BrotherLaur/ApocalypseController/Documentation/CONTROL_Block.png

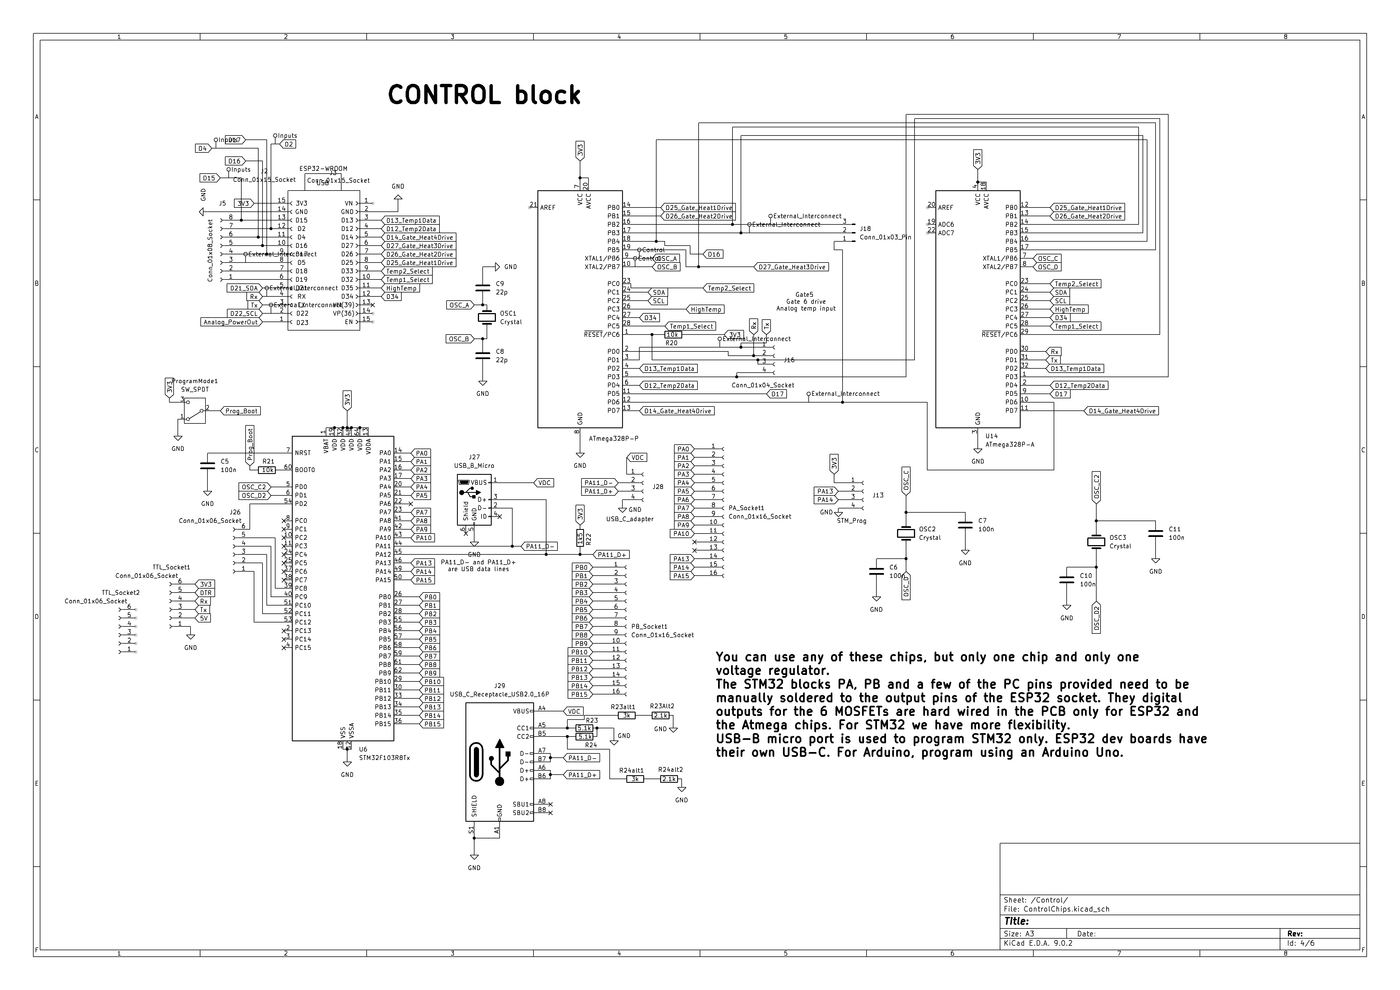
Documentation/CONTROL_Block.png
