BrotherLaur/ApocalypseController/Documentation/GATE_DRIVERS_Block.png

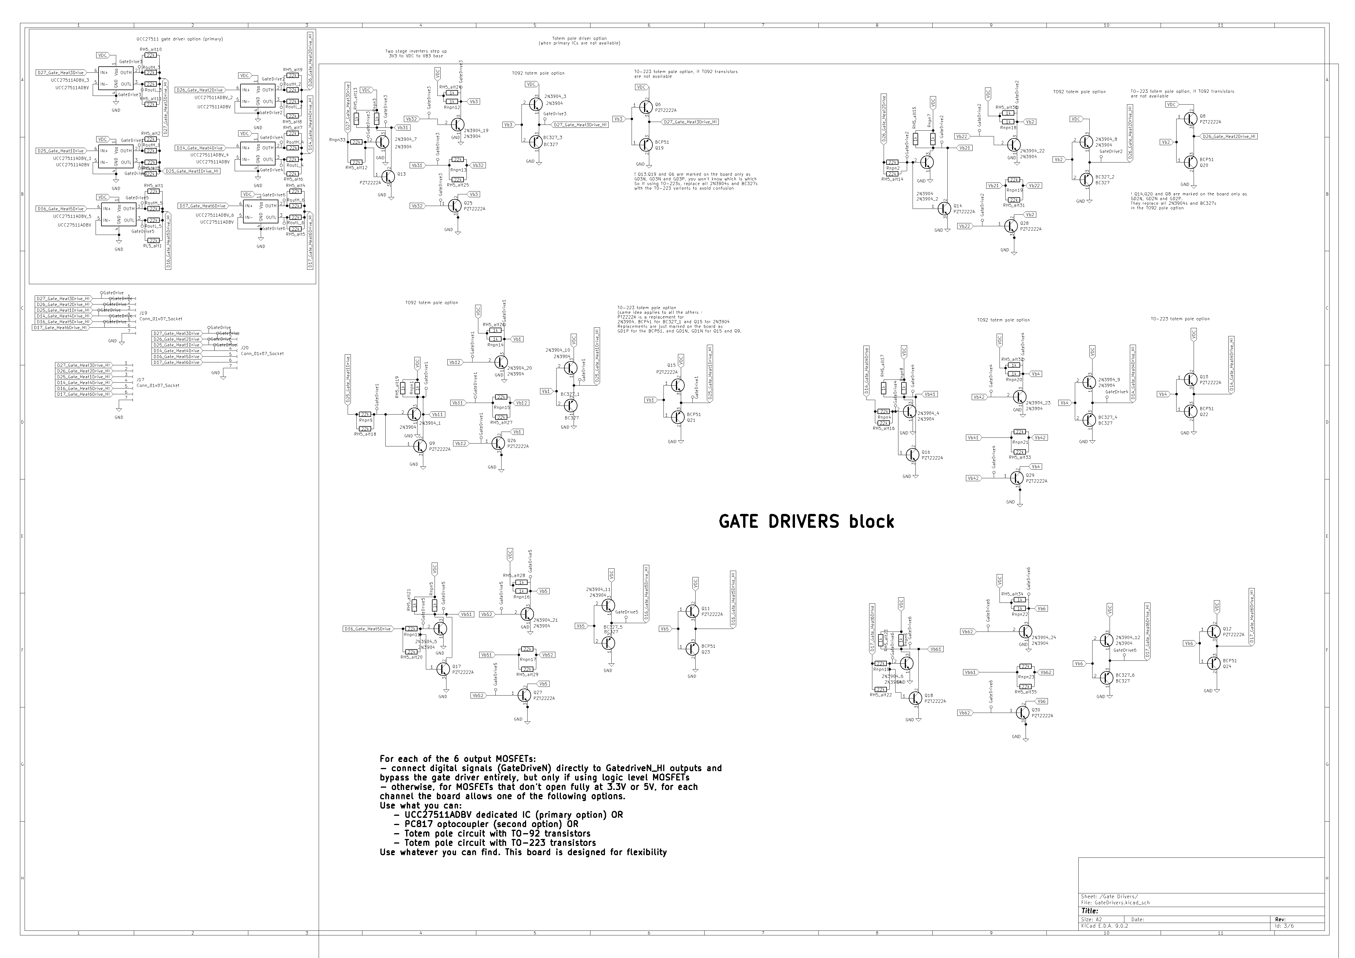
Documentation/GATE_DRIVERS_Block.png
