BrotherLaur/ApocalypseController/Documentation/INPUTS_Block.png

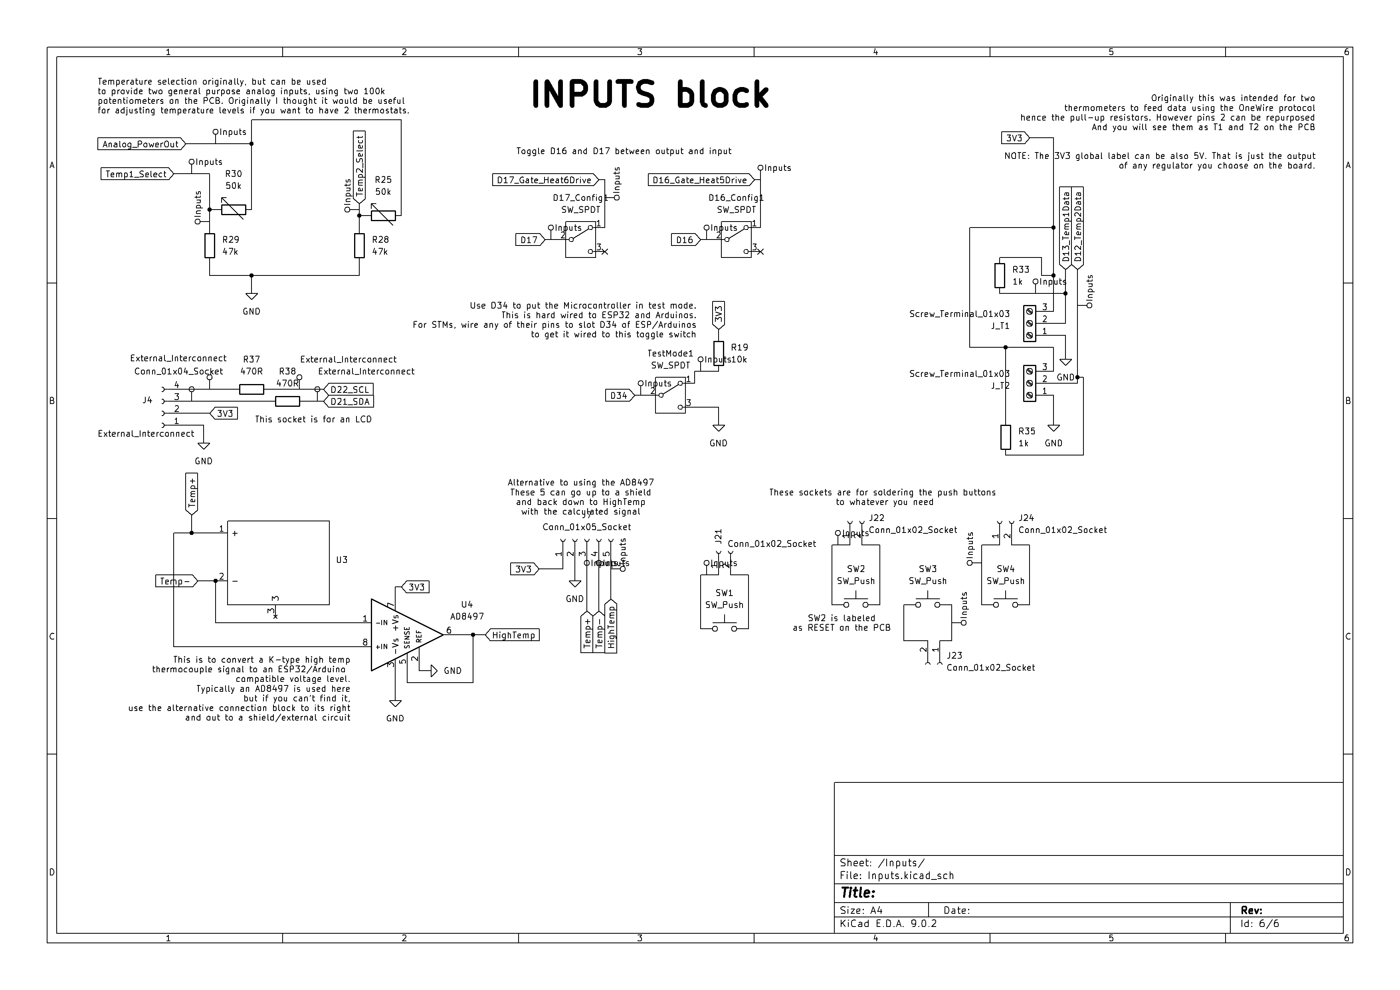
Documentation/INPUTS_Block.png
