BrotherLaur/ApocalypseController/Documentation/OUTPUT_Block.png

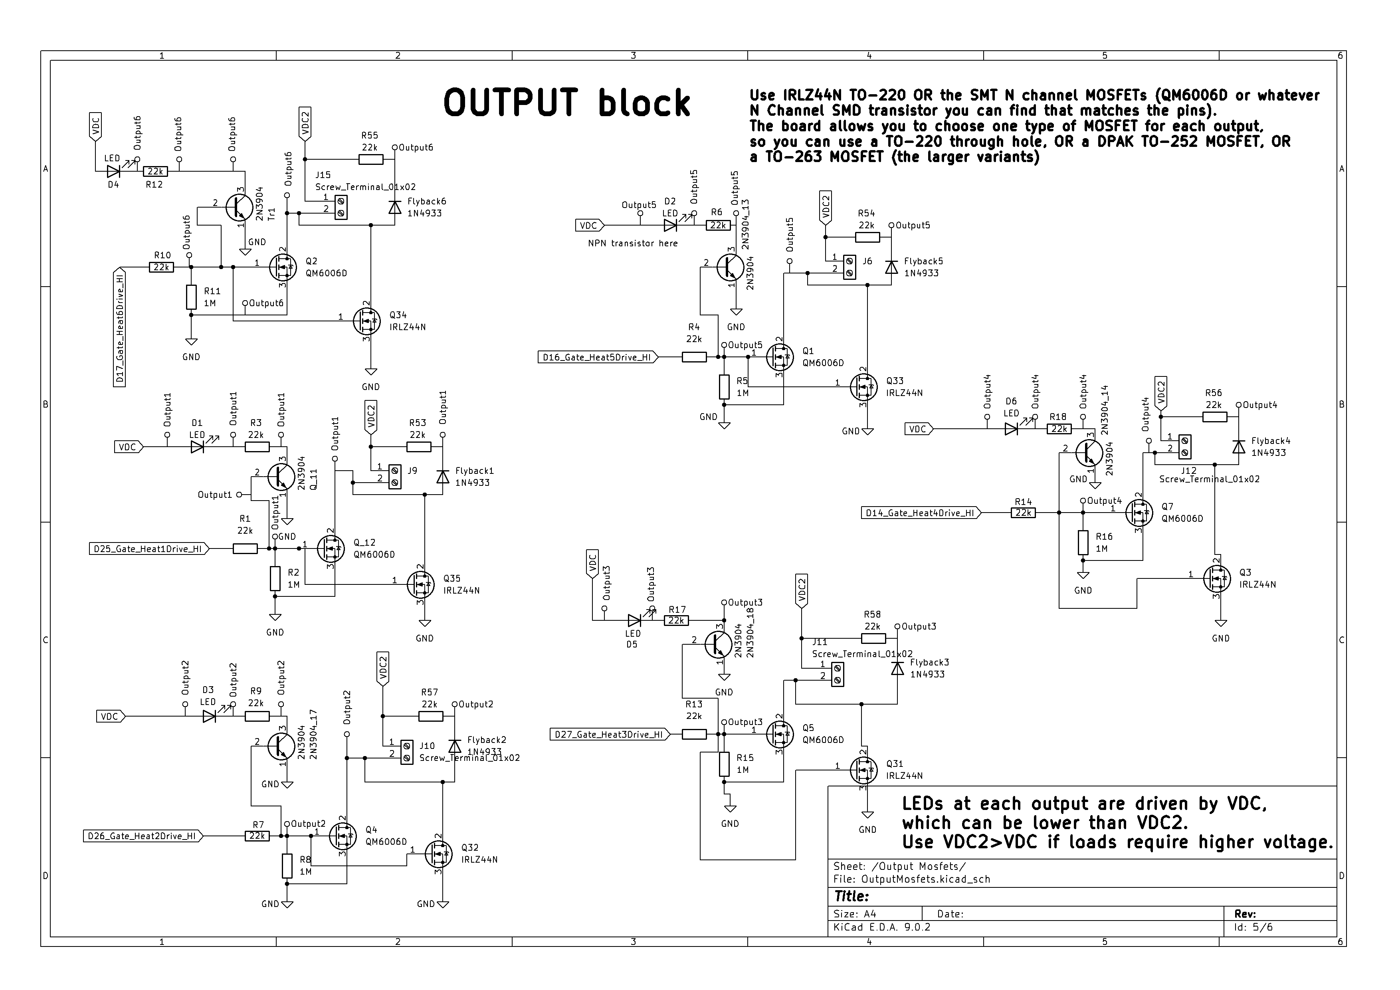
Documentation/OUTPUT_Block.png
