BrotherLaur/ApocalypseController/Documentation/Overview.png

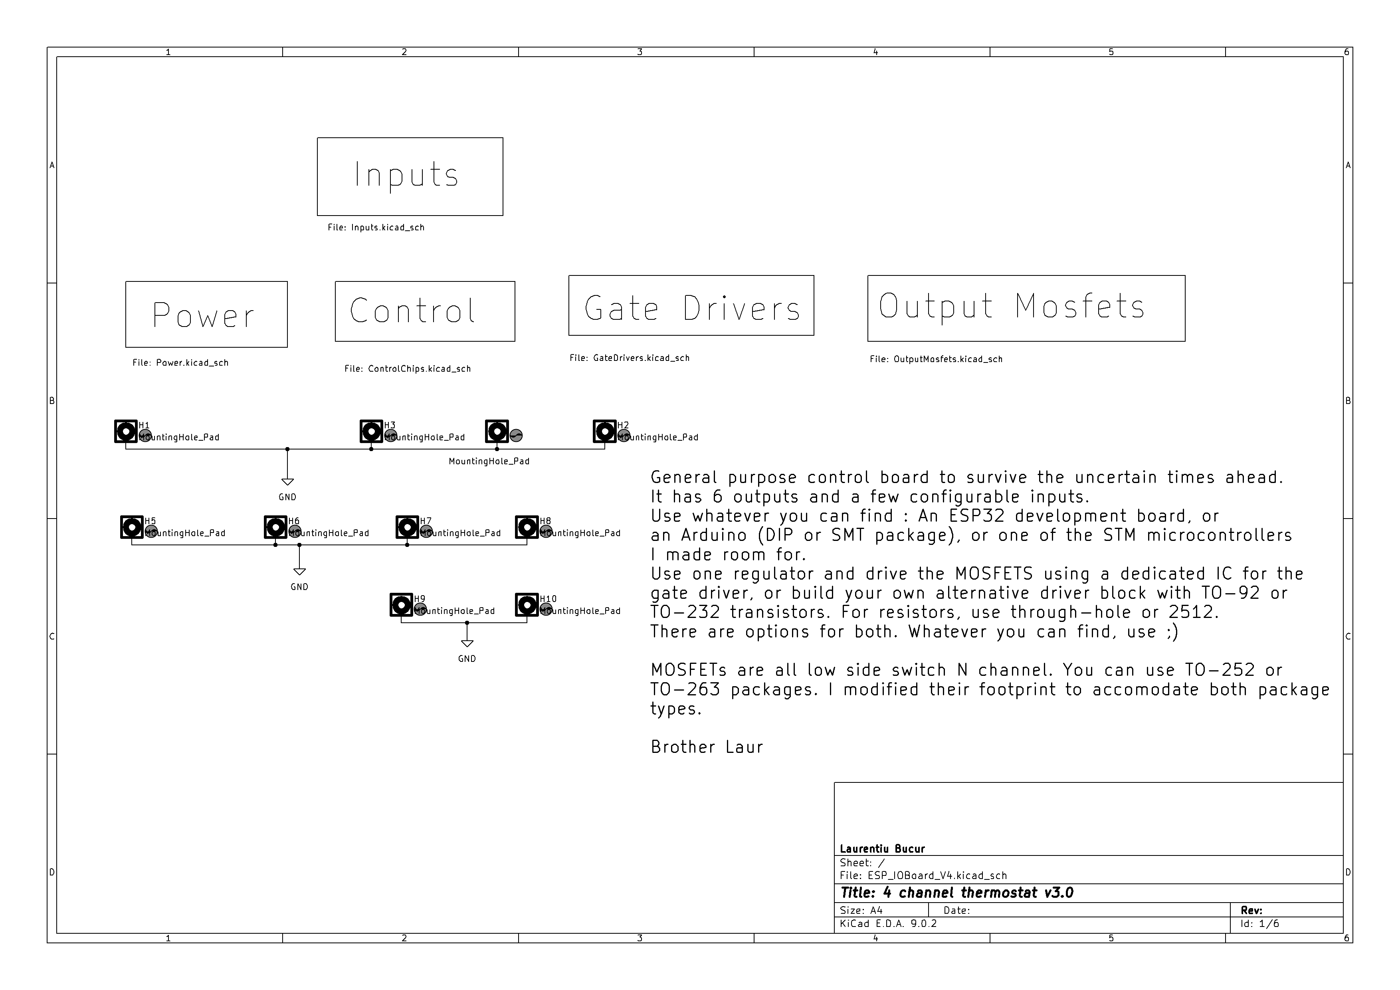
Documentation/Overview.png
