BrotherLaur/ApocalypseController/Documentation/POWER_Block.png

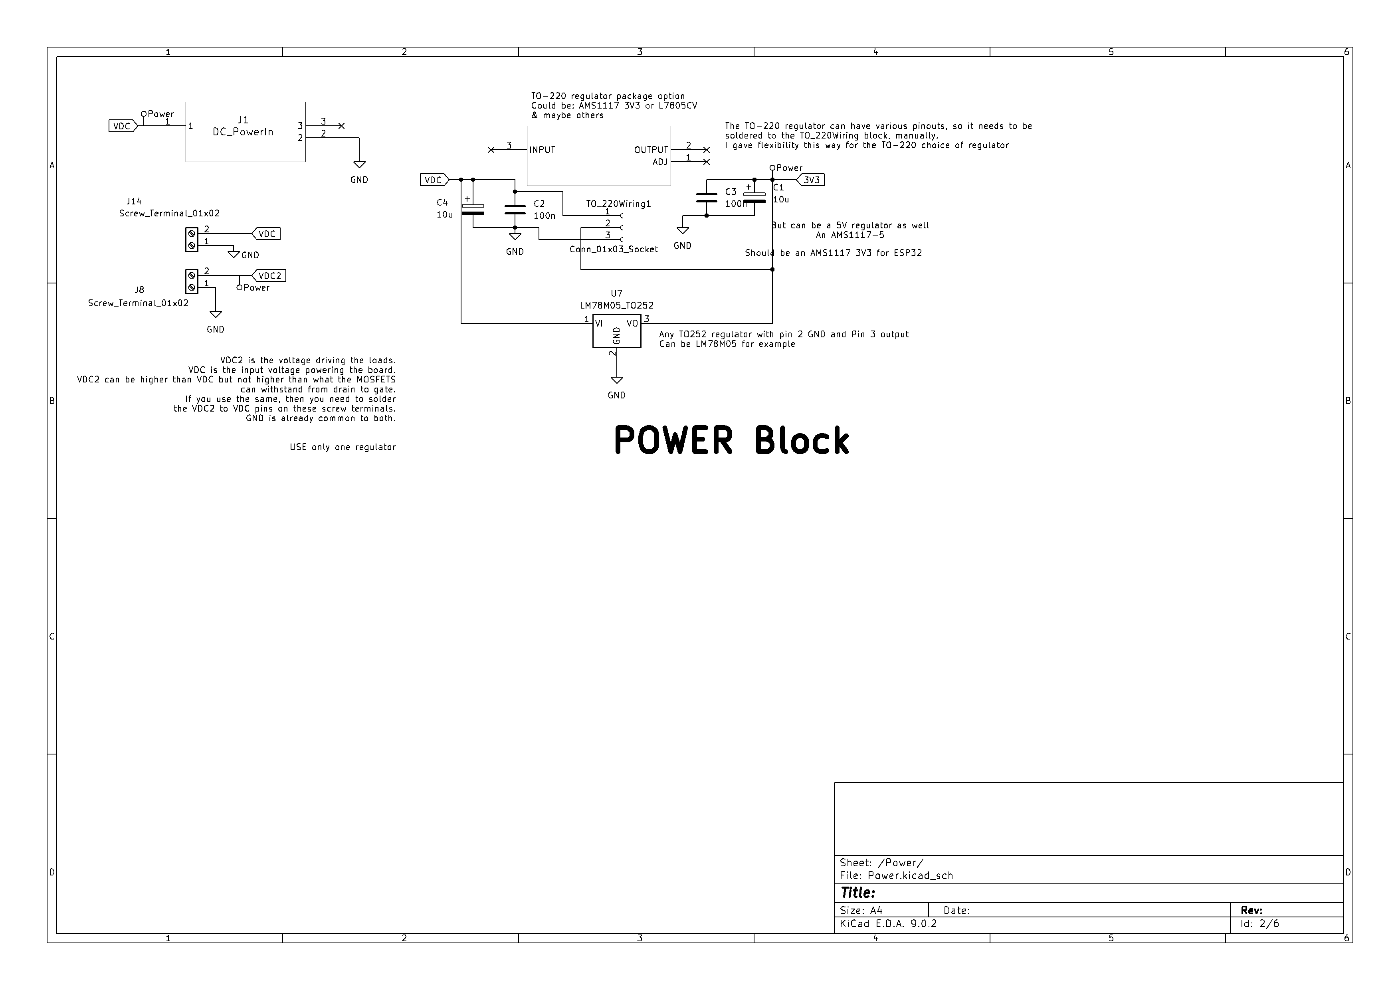
Documentation/POWER_Block.png
