BrotherLaur/ApocalypseController/ControlChips.kicad_sch

## KiCad design ControlChips.kicad_sch (2025-10-03)

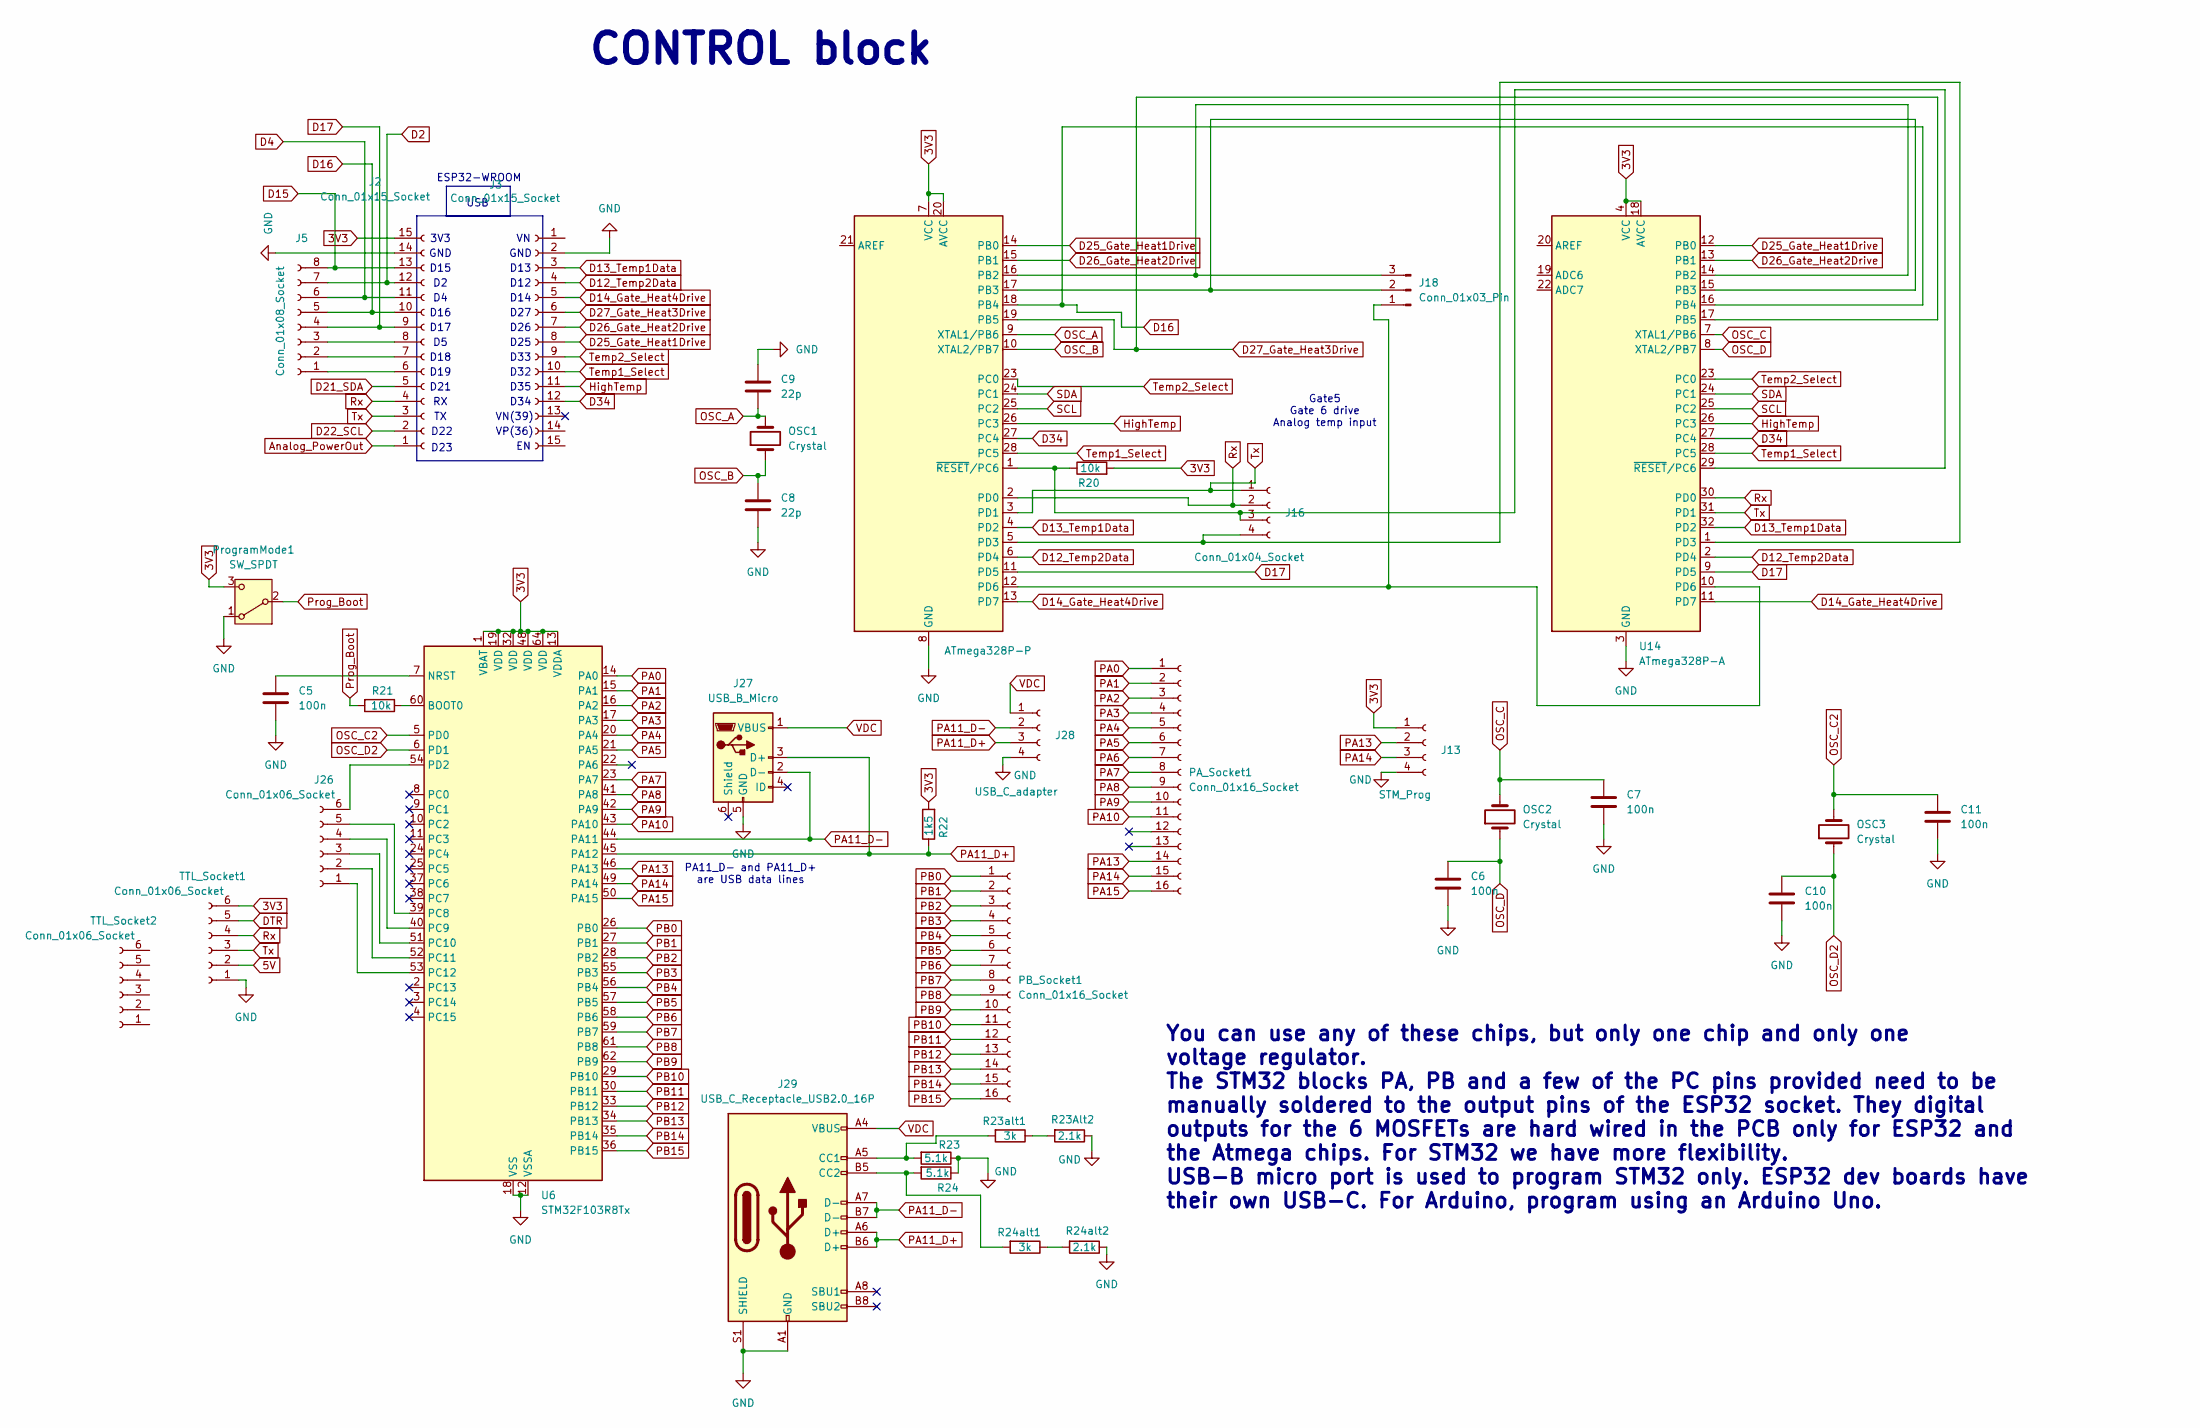
[picture p7: schematic ControlChips.kicad_sch]

Parts:
C5, C6, C7, C10, C11: 100n; C_Rect_L7.0mm_W3.5mm_P5.00mm
C8, C9: 22p; C_Rect_L7.0mm_W3.5mm_P5.00mm
J2, J3: Conn_01x15_Socket; PinSocket_1x15_P2.54mm_Vertical
J5: Conn_01x08_Socket; PinSocket_1x08_P2.54mm_Vertical
J13: STM_Prog; PinSocket_1x04_P2.54mm_Vertical
J16: Conn_01x04_Socket; PinSocket_1x04_P2.54mm_Vertical
J18: Conn_01x03_Pin; PinHeader_1x03_P2.54mm_Vertical
J26: Conn_01x06_Socket; PinSocket_1x06_P2.54mm_Vertical
J27: USB_B_Micro; USB_Micro-B_Wuerth_629105150521
J28: USB_C_adapter; PinSocket_1x04_P2.54mm_Vertical
J29: USB_C_Receptacle_USB2.0_16P; USB_C_Receptacle_GCT_USB4085
OSC1, OSC2, OSC3: Crystal; Crystal_HC49-U_Vertical
PA_Socket1: Conn_01x16_Socket; PinSocket_1x16_P2.54mm_Vertical
PB_Socket1: Conn_01x16_Socket; PinSocket_1x16_P2.54mm_Vertical
ProgramMode1: SW_SPDT; PinHeader_1x03_P2.54mm_Vertical
R20, R21: 10k; R_Axial_Clean
R22: 1k5; R_Axial_Clean
R23, R24: 5.1k; D_2512_6332Metric
R23Alt2, R24alt2: 2.1k; R_Axial_Clean
R23alt1, R24alt1: 3k; R_Axial_Clean
TTL_Socket1, TTL_Socket2: Conn_01x06_Socket; PinSocket_1x06_P2.54mm_Vertical
U5: ATmega328P-P; DIP-28_W7.62mm_Socket
U6: STM32F103R8Tx; LQFP-64_10x10mm_P0.5mm
U14: ATmega328P-A; TQFP-32_SLIM

Connections:
3V3: J2.15, J13.1, ProgramMode1.3 (C), R20.2, R22.2, TTL_Socket1.6, U5.7 (VCC), U5.20 (AVCC), U6.1 (VBAT), U6.13 (VDDA), U6.19 (VDD), U6.32 (VDD), U6.48 (VDD), U6.64 (VDD), U14.4 (VCC), U14.6 (VCC), U14.18 (AVCC)
5V: TTL_Socket1.2
Analog_PowerOut: J2.1
D2: J2.12, J5.7
D4: J2.11, J5.6
D12_Temp2Data: J3.4, U5.6 (PD4), U14.2 (PD4)
D13_Temp1Data: J3.3, U5.4 (PD2), U14.32 (PD2)
D14_Gate_Heat4Drive: J3.5, U5.13 (PD7), U14.11 (PD7)
D15: J2.13, J5.8
D16: J2.10, J5.5, U5.18 (PB4), U14.16 (PB4)
D17: J2.9, J5.4, U5.11 (PD5), U14.9 (PD5)
D21_SDA: J2.5
D22_SCL: J2.2
D25_Gate_Heat1Drive: J3.8, U5.14 (PB0), U14.12 (PB0)
D26_Gate_Heat2Drive: J3.7, U5.15 (PB1), U14.13 (PB1)
D27_Gate_Heat3Drive: J3.6, U5.19 (PB5), U14.17 (PB5)
D34: J3.12, U5.27 (PC4), U14.27 (PC4)
DTR: TTL_Socket1.5
GND: C5.2, C6.2, C7.2, C8.2, C9.1, C10.2, C11.2, J2.14, J3.2, J13.4, J27.5 (GND), J28.4, J29.A1 (GND), J29.A12 (GND), J29.B1 (GND), J29.B12 (GND), J29.S1 (SHIELD), ProgramMode1.1 (A), R23.1, R23Alt2.1, R24.1, R24alt2.1, TTL_Socket1.1, U5.8 (GND), U5.22 (GND), U6.12 (VSSA), U6.18 (VSS), U6.31 (VSS), U6.47 (VSS), U6.63 (VSS), U14.3 (GND), U14.5 (GND), U14.21 (GND)
HighTemp: J3.11, U5.26 (PC3), U14.26 (PC3)
unnamed: C5.1, U6.7 (NRST)
unnamed: J2.6, J5.1
unnamed: J2.7, J5.2
unnamed: J2.8, J5.3
unnamed: J16.3, R20.1, U5.1 (~RESET/PC6), U14.29 (~RESET/PC6)
unnamed: J16.4, U5.5 (PD3), U14.1 (PD3)
unnamed: J18.1, U5.12 (PD6), U14.10 (PD6)
unnamed: J18.2, U5.17 (PB3), U14.15 (PB3)
unnamed: J18.3, U5.16 (PB2), U14.14 (PB2)
unnamed: J26.1, U6.53 (PC12)
unnamed: J26.2, U6.52 (PC11)
unnamed: J26.3, U6.51 (PC10)
unnamed: J26.4, U6.40 (PC9)
unnamed: J26.5, U6.39 (PC8)
unnamed: J26.6, U6.54 (PD2)
unnamed: J29.A5 (CC1), R23.2, R23alt1.2
unnamed: J29.B5 (CC2), R24.2, R24alt1.2
unnamed: R21.1, U6.60 (BOOT0)
unnamed: R23Alt2.2, R23alt1.1
unnamed: R24alt1.1, R24alt2.2
OSC_A: C9.2, OSC1.2, U5.9 (XTAL1/PB6)
OSC_B: C8.1, OSC1.1, U5.10 (XTAL2/PB7)
OSC_C: C7.1, OSC2.2, U14.7 (XTAL1/PB6)
OSC_C2: C11.1, OSC3.2, U6.5 (PD0)
OSC_D: C6.1, OSC2.1, U14.8 (XTAL2/PB7)
OSC_D2: C10.1, OSC3.1, U6.6 (PD1)
PA0: PA_Socket1.1, U6.14 (PA0)
PA1: PA_Socket1.2, U6.15 (PA1)
PA2: PA_Socket1.3, U6.16 (PA2)
PA3: PA_Socket1.4, U6.17 (PA3)
PA4: PA_Socket1.5, U6.20 (PA4)
PA5: PA_Socket1.6, U6.21 (PA5)
PA6: PA_Socket1.7
PA7: PA_Socket1.8, U6.23 (PA7)
PA8: PA_Socket1.9, U6.41 (PA8)
PA9: PA_Socket1.10, U6.42 (PA9)
PA10: PA_Socket1.11, U6.43 (PA10)
PA11_D+: J27.3 (D+), J28.3, J29.A6 (D+), J29.B6 (D+), R22.1, U6.45 (PA12)
PA11_D-: J27.2 (D-), J28.2, J29.A7 (D-), J29.B7 (D-), U6.44 (PA11)
PA13: J13.2, PA_Socket1.14, U6.46 (PA13)
PA14: J13.3, PA_Socket1.15, U6.49 (PA14)
PA15: PA_Socket1.16, U6.50 (PA15)
PB0: PB_Socket1.1, U6.26 (PB0)
PB1: PB_Socket1.2, U6.27 (PB1)
PB2: PB_Socket1.3, U6.28 (PB2)
PB3: PB_Socket1.4, U6.55 (PB3)
PB4: PB_Socket1.5, U6.56 (PB4)
PB5: PB_Socket1.6, U6.57 (PB5)
PB6: PB_Socket1.7, U6.58 (PB6)
PB7: PB_Socket1.8, U6.59 (PB7)
PB8: PB_Socket1.9, U6.61 (PB8)
PB9: PB_Socket1.10, U6.62 (PB9)
PB10: PB_Socket1.11, U6.29 (PB10)
PB11: PB_Socket1.12, U6.30 (PB11)
PB12: PB_Socket1.13, U6.33 (PB12)
PB13: PB_Socket1.14, U6.34 (PB13)
PB14: PB_Socket1.15, U6.35 (PB14)
PB15: PB_Socket1.16, U6.36 (PB15)
Prog_Boot: ProgramMode1.2 (B), R21.2
Rx: J2.4, J16.2, TTL_Socket1.4, U5.2 (PD0), U14.30 (PD0)
SCL: U5.25 (PC2), U14.25 (PC2)
SDA: U5.24 (PC1), U14.24 (PC1)
Temp1_Select: J3.10, U5.28 (PC5), U14.28 (PC5)
Temp2_Select: J3.9, U5.23 (PC0), U14.23 (PC0)
Tx: J2.3, J16.1, TTL_Socket1.3, U5.3 (PD1), U14.31 (PD1)
VDC: J27.1 (VBUS), J28.1, J29.A4 (VBUS), J29.A9 (VBUS), J29.B4 (VBUS), J29.B9 (VBUS)

Notes on the sheet:
CONTROL block
D17
D21
D25
D26
D22
You can use any of these chips, but only one chip and only one voltage regulator. The STM32 blocks PA, PB and a few of the PC pins provided need to be manually soldered to the output pins of the ESP32 socket. They digital outputs for the 6 MOSFETs are hard wired in the PCB only for ESP32 and the At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
D19
GND
VP(36)
D32
D35
ESP32-WROOM
D14
PA11_D- and PA11_D+ are USB data lines
D16
3V3
D15
USB
VN(39)
D18
D12
Gate5 Gate 6 drive Analog temp input
D27
D23
D33
D13
D34
