BrotherLaur/ApocalypseController/ESP_IOBoard_V4.kicad_sch

## KiCad design ESP_IOBoard_V4.kicad_sch (2025-10-03)

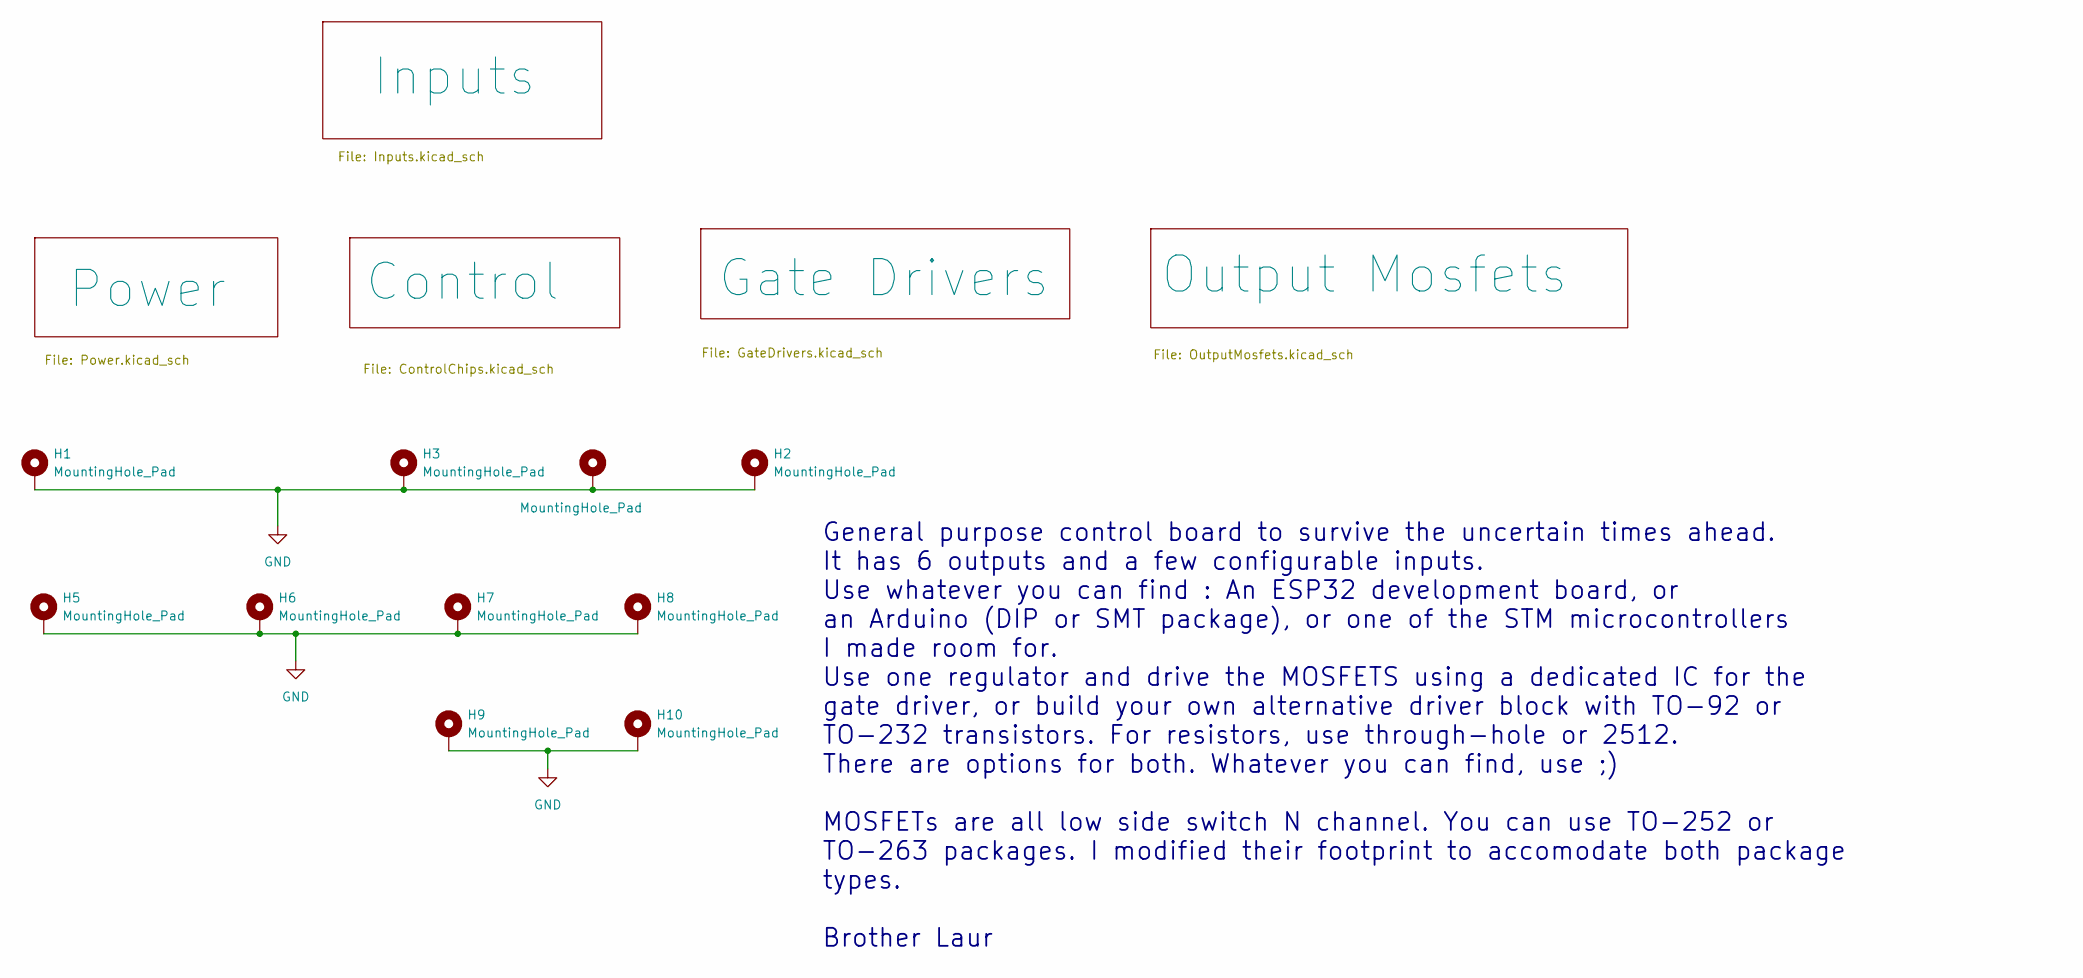
[picture p8: schematic ESP_IOBoard_V4.kicad_sch]

Parts:
H1, H2, H3, H4, H5, H6, H7, H8, H9, H10: MountingHole_Pad; MountingHole_2.7mm_M2.5_Pad_Via

Connections:
GND: H1.1, H2.1, H3.1, H4.1, H5.1, H6.1, H7.1, H8.1, H9.1, H10.1

Notes on the sheet:
General purpose control board to survive the uncertain times ahead. It has 6 outputs and a few configurable inputs. Use whatever you can find : An ESP32 development board, or an Arduino (DIP or SMT package), or one of the STM microcontrollers I made room for. Use one regulator and drive the MOSFETS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
