BrotherLaur/ApocalypseController/GateDrivers.kicad_sch

## KiCad design GateDrivers.kicad_sch (2025-10-03)

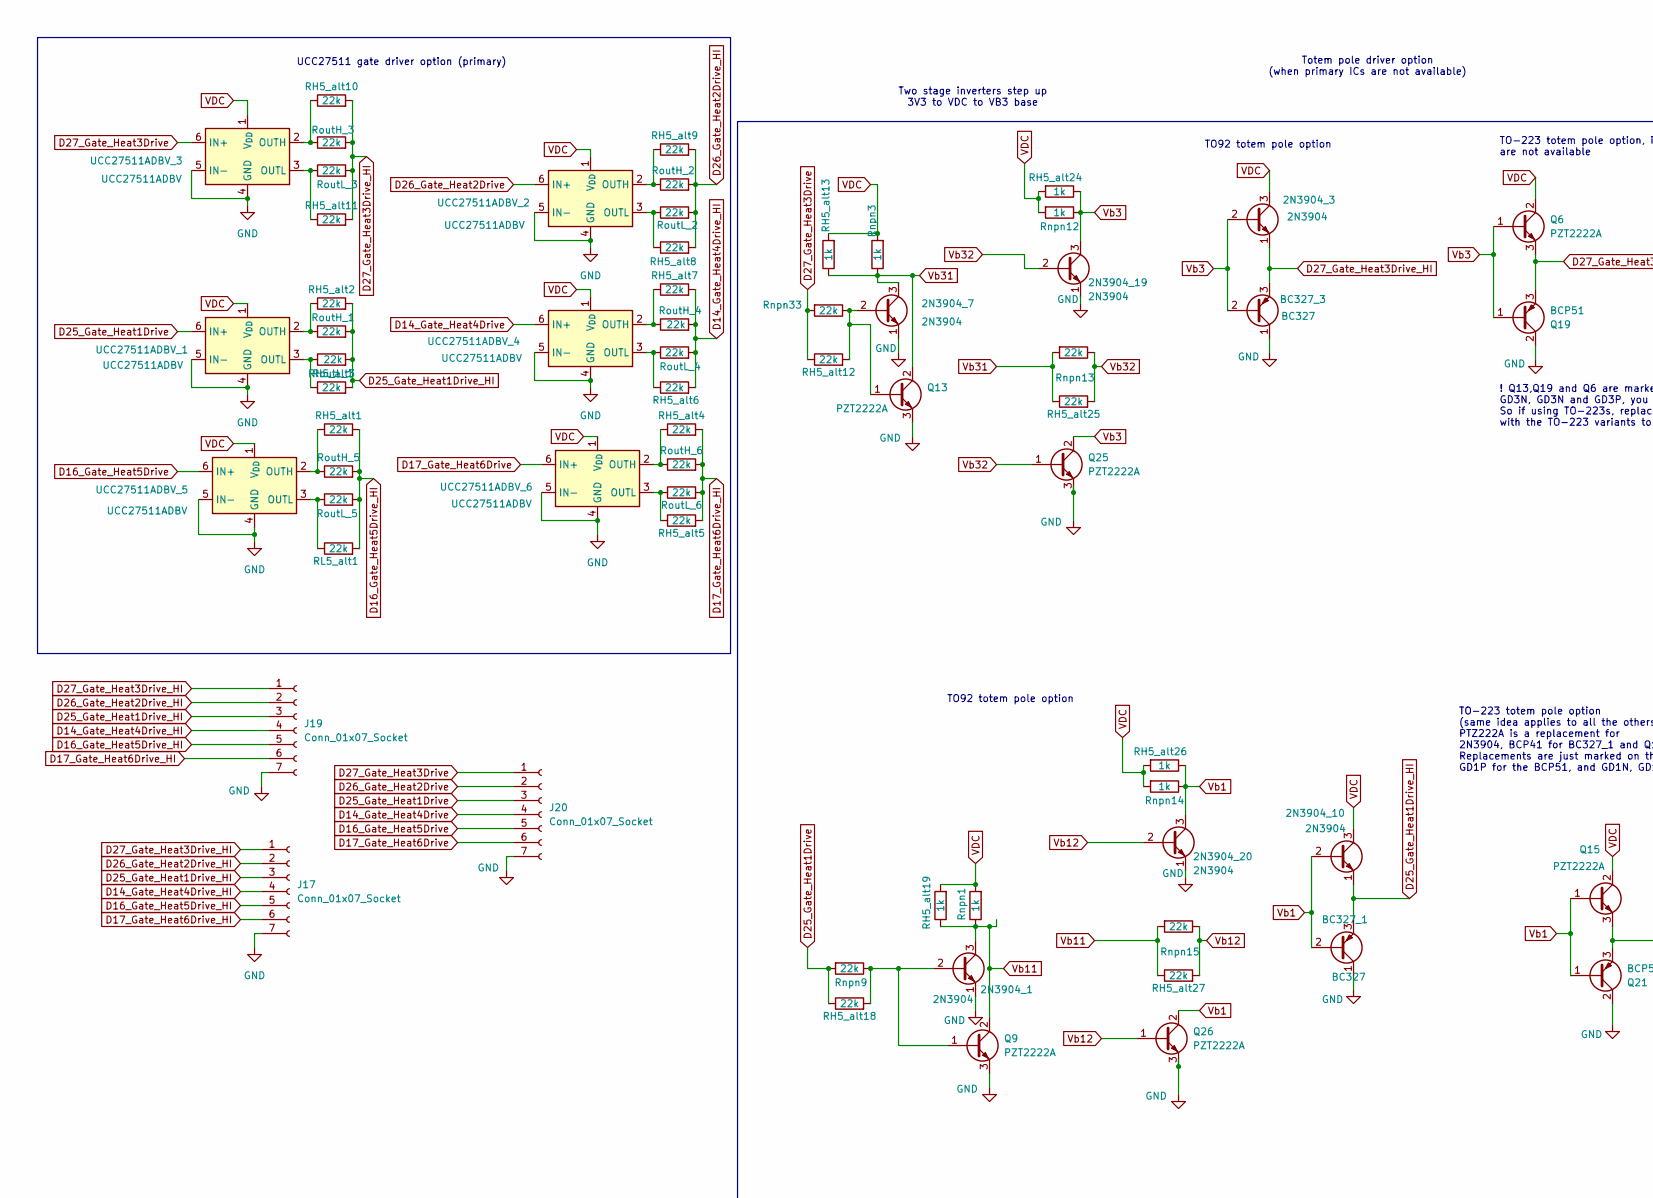
[picture p9: schematic GateDrivers.kicad_sch, part in row 1, column 1]

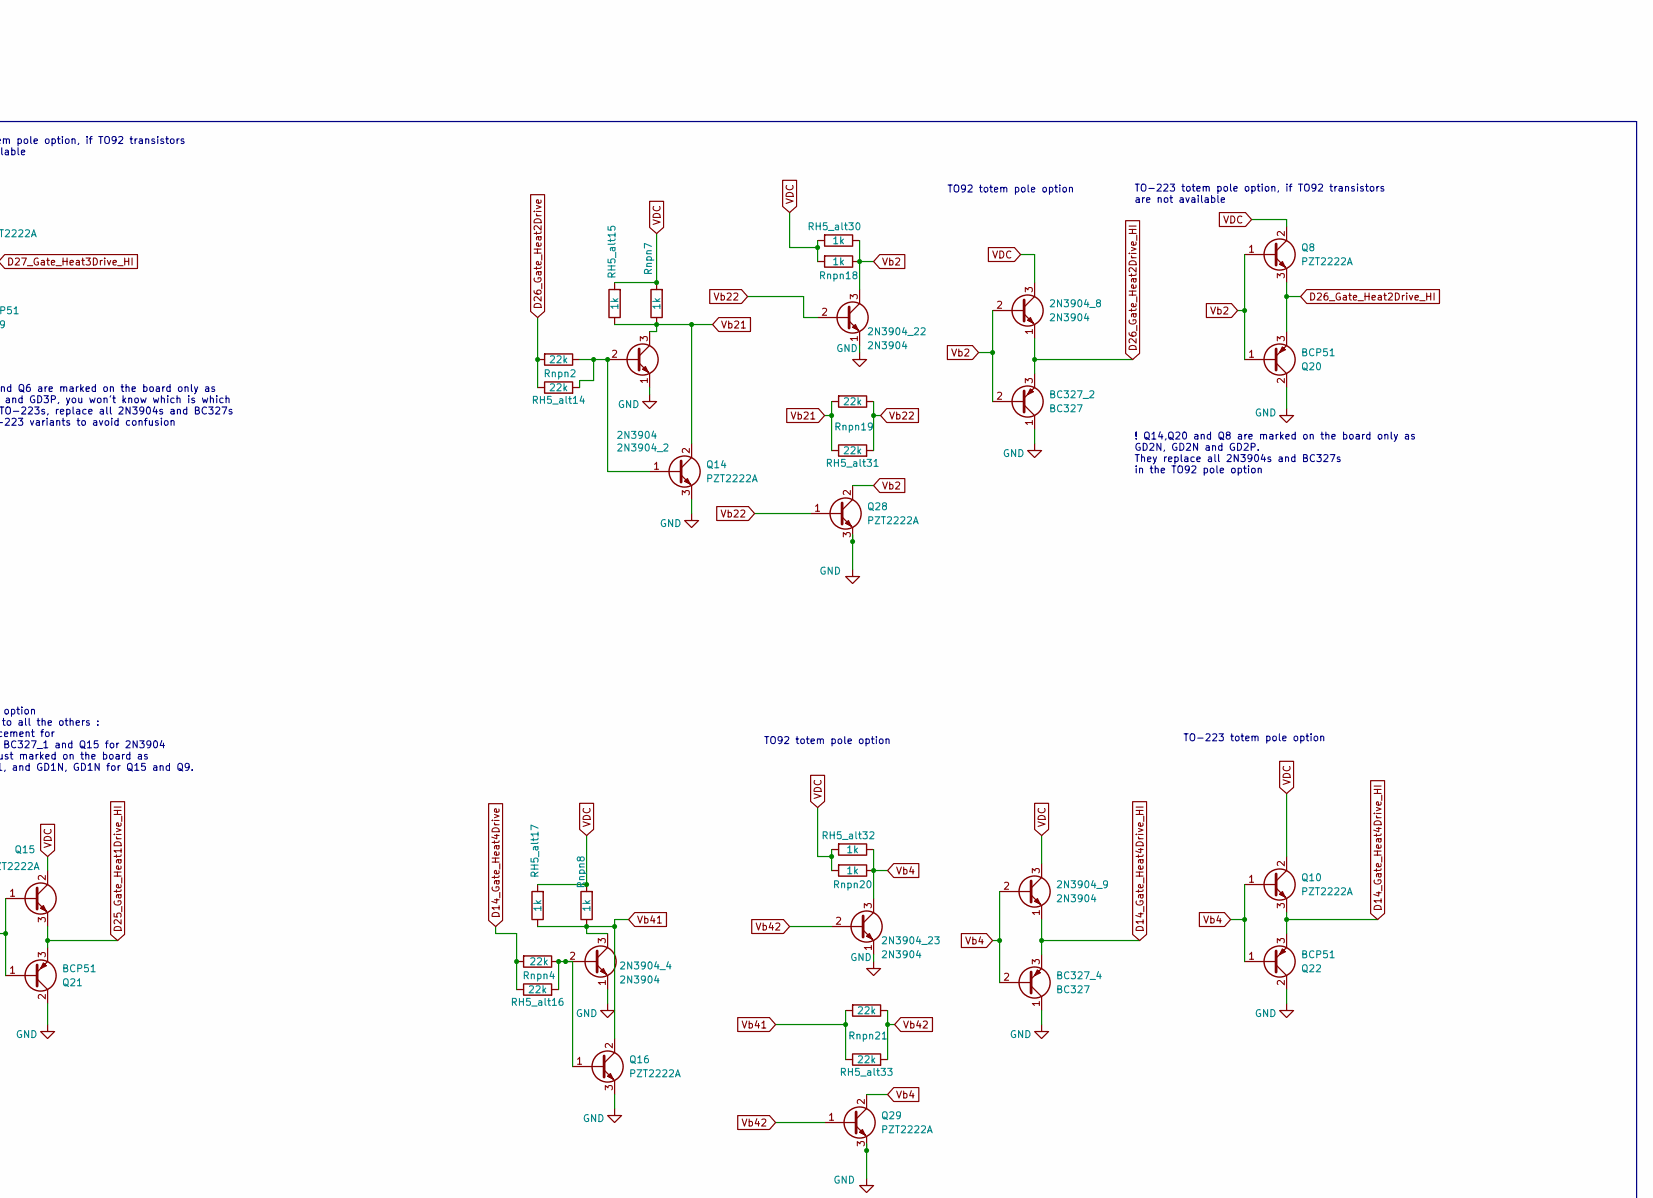
[picture p10: schematic GateDrivers.kicad_sch, part in row 1, column 2]

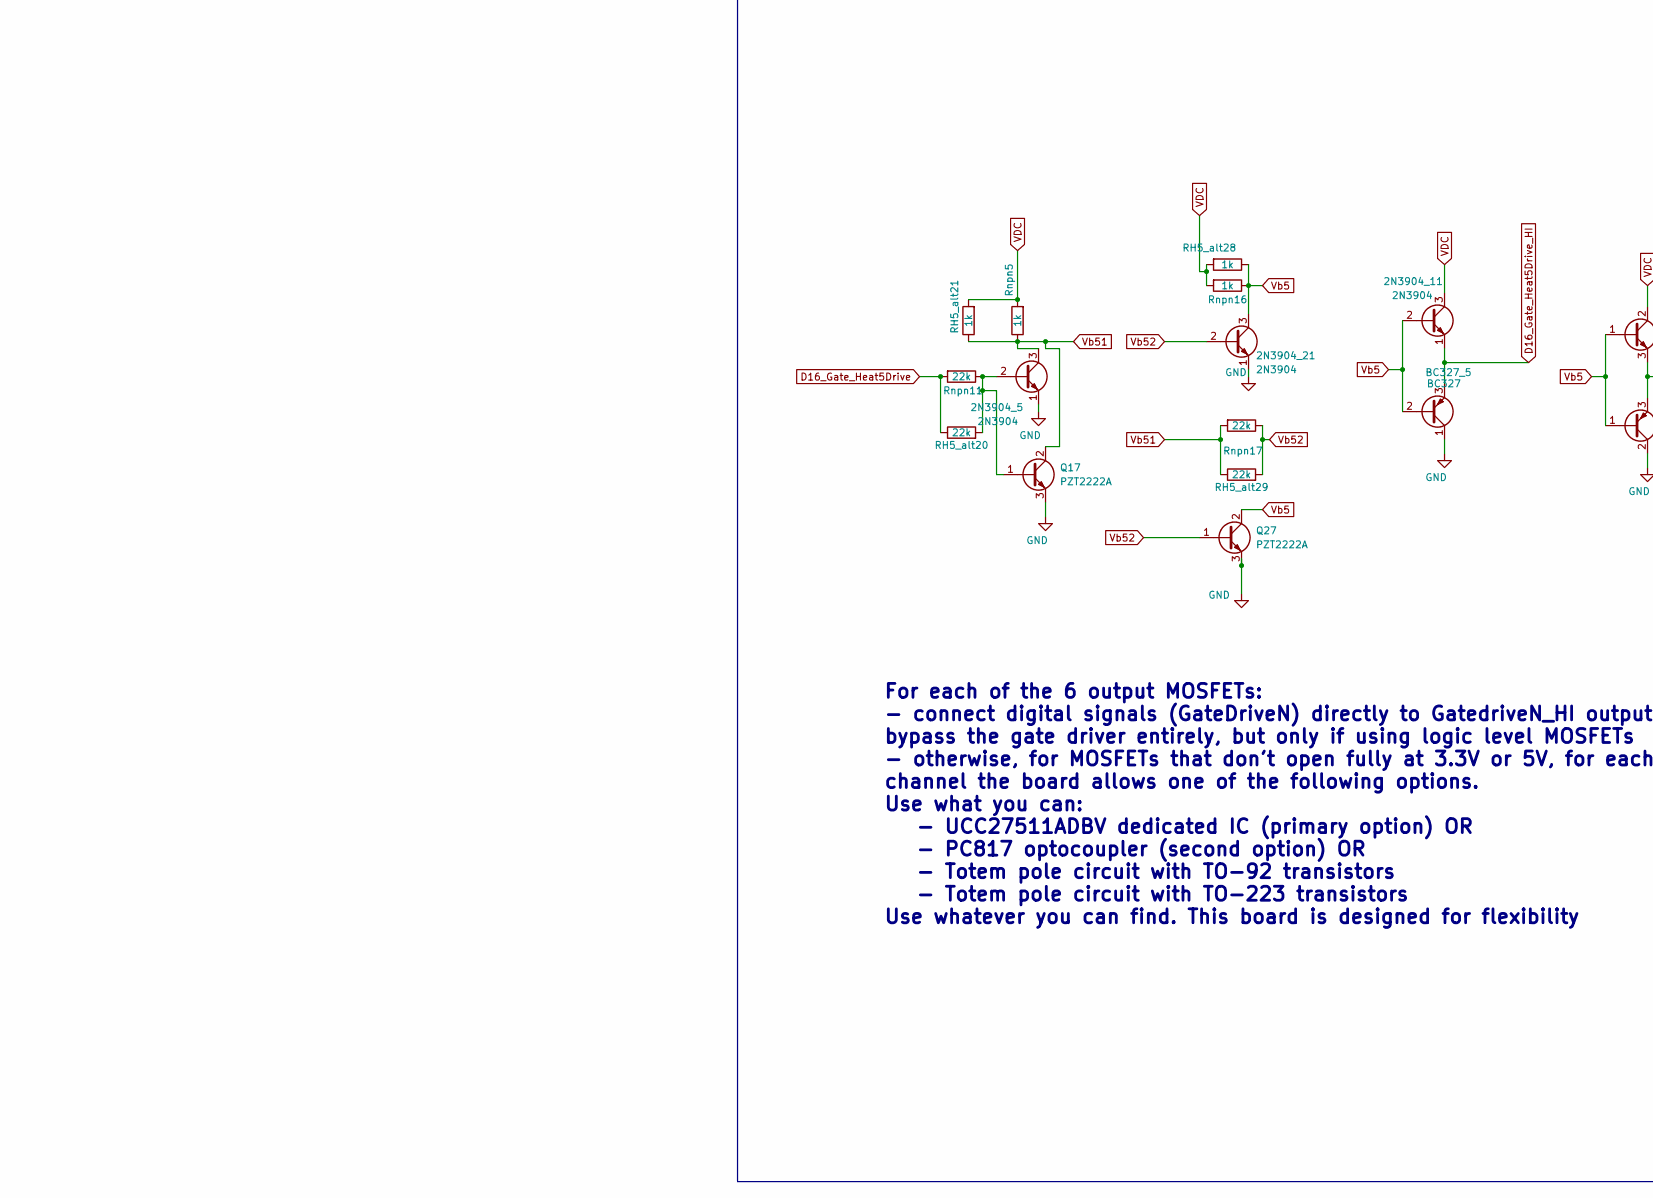
[picture p11: schematic GateDrivers.kicad_sch, part in row 2, column 1]

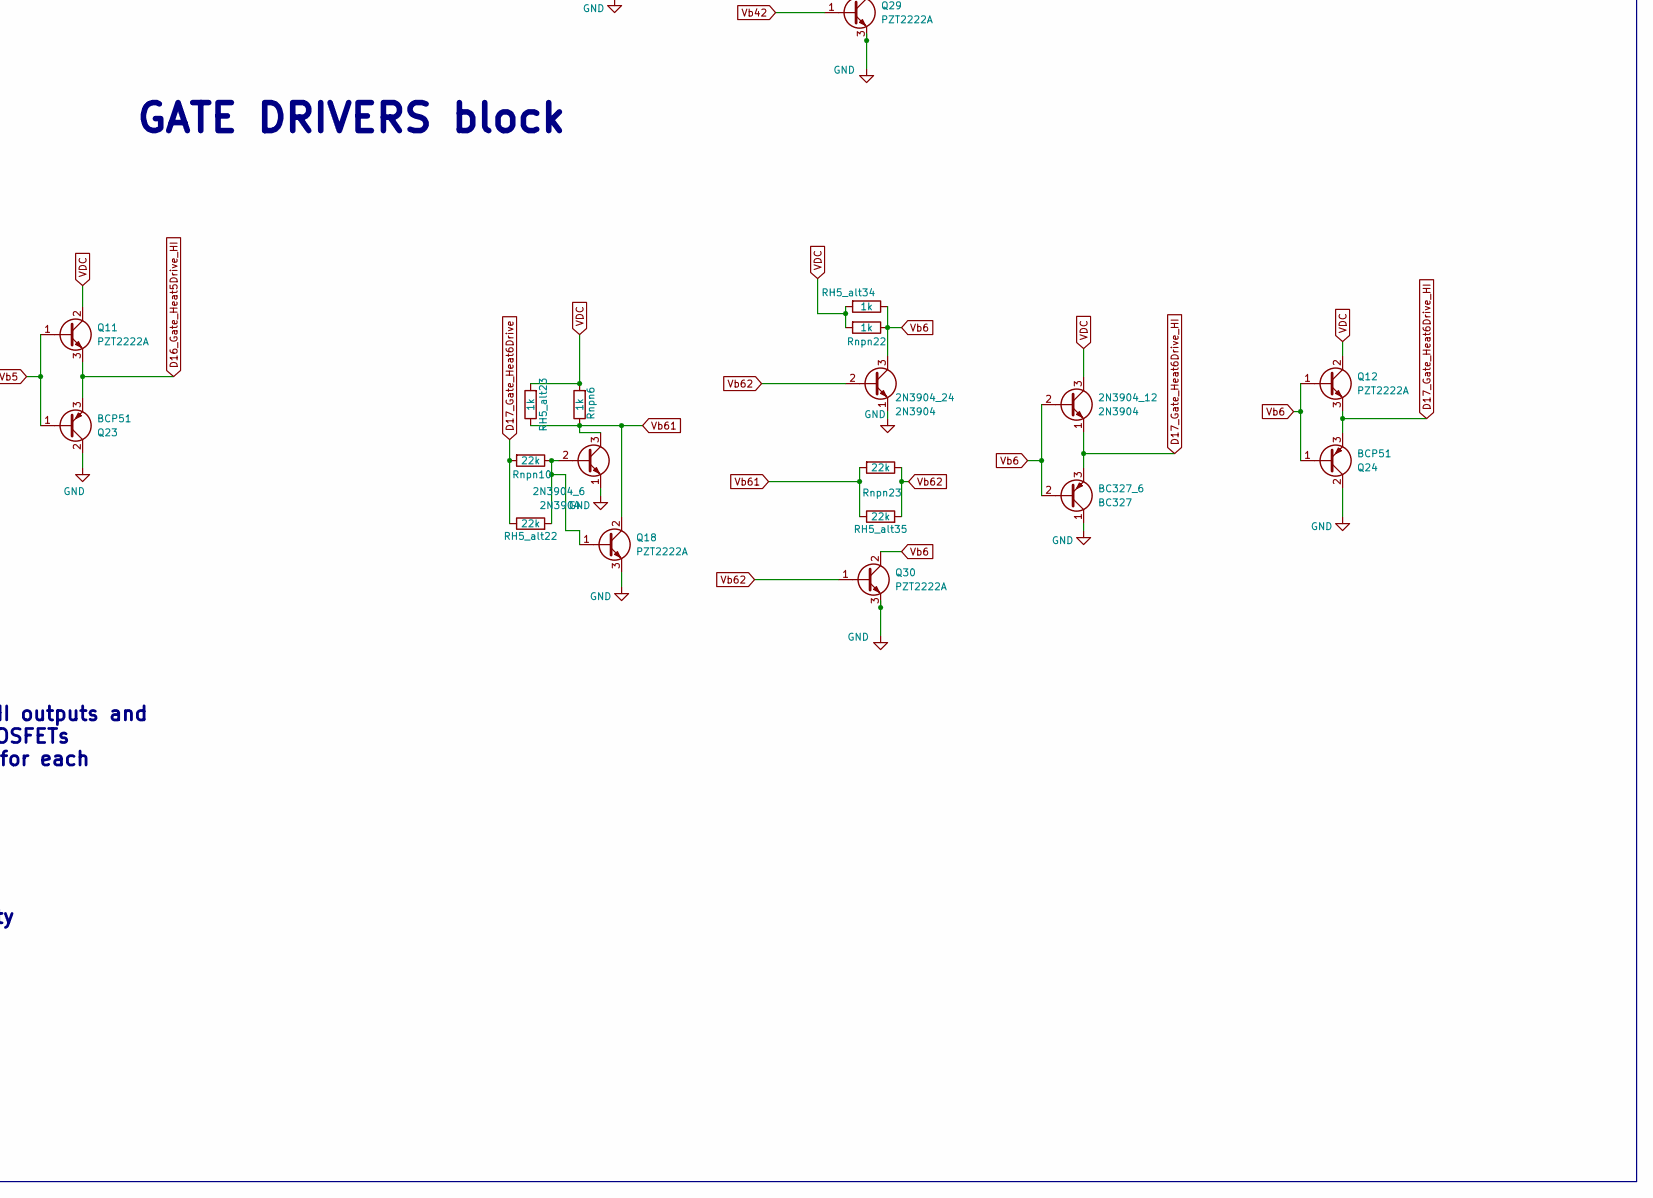
[picture p12: schematic GateDrivers.kicad_sch, part in row 2, column 2]

Parts:
2N3904_1, 2N3904_2, 2N3904_3, 2N3904_4, 2N3904_5, 2N3904_6, 2N3904_7, 2N3904_8, 2N3904_9, 2N3904_10, 2N3904_11, 2N3904_12, 2N3904_19, 2N3904_20, 2N3904_21, 2N3904_22, 2N3904_23, 2N3904_24: 2N3904; TO-92_Expanded
BC327_1, BC327_2, BC327_3, BC327_4, BC327_5, BC327_6: BC327; TO-92_Expanded
J17, J19, J20: Conn_01x07_Socket; PinSocket_1x07_P2.54mm_Vertical
Q6, Q8, Q9, Q10, Q11, Q12, Q13, Q14, Q15, Q16, Q17, Q18, Q25, Q26, Q27, Q28, Q29, Q30: PZT2222A; SOT-223-3_TabPin2
Q19, Q20, Q21, Q22, Q23, Q24: BCP51; SOT-223-3_TabPin2
RH5_alt1, RH5_alt2, RH5_alt3, RH5_alt4, RH5_alt5, RH5_alt6, RH5_alt7, RH5_alt8, RH5_alt9, RH5_alt10, RH5_alt11, RH5_alt12, RH5_alt14, RH5_alt16, RH5_alt18, RH5_alt20, RH5_alt22, RH5_alt25, RH5_alt27, RH5_alt29, RH5_alt31, RH5_alt33, RH5_alt35: 22k; D_2512_6332Metric
RH5_alt13, RH5_alt15, RH5_alt17, RH5_alt19, RH5_alt21, RH5_alt23, RH5_alt24, RH5_alt26, RH5_alt28, RH5_alt30, RH5_alt32, RH5_alt34: 1k; D_2512_6332Metric
RL5_alt1: 22k; D_2512_6332Metric
Rnpn1, Rnpn3, Rnpn5, Rnpn6, Rnpn7, Rnpn8, Rnpn12, Rnpn14, Rnpn16, Rnpn18, Rnpn20, Rnpn22: 1k; R_Axial_Clean
Rnpn2, Rnpn4, Rnpn9, Rnpn10, Rnpn11, Rnpn13, Rnpn15, Rnpn17, Rnpn19, Rnpn21, Rnpn23, Rnpn33: 22k; R_Axial_Clean
RoutH_1, RoutH_2, RoutH_3, RoutH_4, RoutH_5, RoutH_6: 22k; R_Axial_Clean
RoutL_1, RoutL_2, RoutL_3, RoutL_4, RoutL_5, RoutL_6: 22k; R_Axial_Clean
UCC27511ADBV_1, UCC27511ADBV_2, UCC27511ADBV_3, UCC27511ADBV_4, UCC27511ADBV_5, UCC27511ADBV_6: UCC27511ADBV; SOT-23-6

Connections:
D14_Gate_Heat4Drive: J20.4, RH5_alt16.1, Rnpn4.2, UCC27511ADBV_4.6 (IN+)
D14_Gate_Heat4Drive_HI: 2N3904_9.1 (E), BC327_4.3 (E), J17.4, J19.4, Q10.3 (E), Q22.3 (E), RH5_alt6.2, RH5_alt7.2, RoutH_4.2, RoutL_4.2
D16_Gate_Heat5Drive: J20.5, RH5_alt20.1, Rnpn11.2, UCC27511ADBV_5.6 (IN+)
D16_Gate_Heat5Drive_HI: 2N3904_11.1 (E), BC327_5.3 (E), J17.5, J19.5, Q11.3 (E), Q23.3 (E), RH5_alt1.2, RL5_alt1.2, RoutH_5.2, RoutL_5.2
D17_Gate_Heat6Drive: J20.6, RH5_alt22.1, Rnpn10.2, UCC27511ADBV_6.6 (IN+)
D17_Gate_Heat6Drive_HI: 2N3904_12.1 (E), BC327_6.3 (E), J17.6, J19.6, Q12.3 (E), Q24.3 (E), RH5_alt4.2, RH5_alt5.2, RoutH_6.2, RoutL_6.2
D25_Gate_Heat1Drive: J20.3, RH5_alt18.1, Rnpn9.2, UCC27511ADBV_1.6 (IN+)
D25_Gate_Heat1Drive_HI: 2N3904_10.1 (E), BC327_1.3 (E), J17.3, J19.3, Q15.3 (E), Q21.3 (E), RH5_alt2.2, RH5_alt3.2, RoutH_1.2, RoutL_1.2
D26_Gate_Heat2Drive: J20.2, RH5_alt14.1, Rnpn2.2, UCC27511ADBV_2.6 (IN+)
D26_Gate_Heat2Drive_HI: 2N3904_8.1 (E), BC327_2.3 (E), J17.2, J19.2, Q8.3 (E), Q20.3 (E), RH5_alt8.2, RH5_alt9.2, RoutH_2.2, RoutL_2.2
D27_Gate_Heat3Drive: J20.1, RH5_alt12.1, Rnpn33.2, UCC27511ADBV_3.6 (IN+)
D27_Gate_Heat3Drive_HI: 2N3904_3.1 (E), BC327_3.3 (E), J17.1, J19.1, Q6.3 (E), Q19.3 (E), RH5_alt10.2, RH5_alt11.2, RoutH_3.2, RoutL_3.2
GND: 2N3904_1.1 (E), 2N3904_2.1 (E), 2N3904_4.1 (E), 2N3904_5.1 (E), 2N3904_6.1 (E), 2N3904_7.1 (E), 2N3904_19.1 (E), 2N3904_20.1 (E), 2N3904_21.1 (E), 2N3904_22.1 (E), 2N3904_23.1 (E), 2N3904_24.1 (E), BC327_1.1 (C), BC327_2.1 (C), BC327_3.1 (C), BC327_4.1 (C), BC327_5.1 (C), BC327_6.1 (C), J17.7, J19.7, J20.7, Q9.3 (E), Q13.3 (E), Q14.3 (E), Q16.3 (E), Q17.3 (E), Q18.3 (E), Q19.2 (C), Q20.2 (C), Q21.2 (C), Q22.2 (C), Q23.2 (C), Q24.2 (C), Q25.3 (E), Q26.3 (E), Q27.3 (E), Q28.3 (E), Q29.3 (E), Q30.3 (E), UCC27511ADBV_1.4 (GND), UCC27511ADBV_1.5 (IN-), UCC27511ADBV_2.4 (GND), UCC27511ADBV_2.5 (IN-), UCC27511ADBV_3.4 (GND), UCC27511ADBV_3.5 (IN-), UCC27511ADBV_4.4 (GND), UCC27511ADBV_4.5 (IN-), UCC27511ADBV_5.4 (GND), UCC27511ADBV_5.5 (IN-), UCC27511ADBV_6.4 (GND), UCC27511ADBV_6.5 (IN-)
unnamed: 2N3904_1.2 (B), Q9.1 (B), RH5_alt18.2, Rnpn9.1
unnamed: 2N3904_2.2 (B), Q14.1 (B), RH5_alt14.2, Rnpn2.1
unnamed: 2N3904_4.2 (B), Q16.1 (B), RH5_alt16.2, Rnpn4.1
unnamed: 2N3904_5.2 (B), Q17.1 (B), RH5_alt20.2, Rnpn11.1
unnamed: 2N3904_6.2 (B), Q18.1 (B), RH5_alt22.2, Rnpn10.1
unnamed: 2N3904_7.2 (B), Q13.1 (B), RH5_alt12.2, Rnpn33.1
unnamed: RH5_alt1.1, RoutH_5.1, UCC27511ADBV_5.2 (OUTH)
unnamed: RH5_alt2.1, RoutH_1.1, UCC27511ADBV_1.2 (OUTH)
unnamed: RH5_alt3.1, RoutL_1.1, UCC27511ADBV_1.3 (OUTL)
unnamed: RH5_alt4.1, RoutH_6.1, UCC27511ADBV_6.2 (OUTH)
unnamed: RH5_alt5.1, RoutL_6.1, UCC27511ADBV_6.3 (OUTL)
unnamed: RH5_alt6.1, RoutL_4.1, UCC27511ADBV_4.3 (OUTL)
unnamed: RH5_alt7.1, RoutH_4.1, UCC27511ADBV_4.2 (OUTH)
unnamed: RH5_alt8.1, RoutL_2.1, UCC27511ADBV_2.3 (OUTL)
unnamed: RH5_alt9.1, RoutH_2.1, UCC27511ADBV_2.2 (OUTH)
unnamed: RH5_alt10.1, RoutH_3.1, UCC27511ADBV_3.2 (OUTH)
unnamed: RH5_alt11.1, RoutL_3.1, UCC27511ADBV_3.3 (OUTL)
unnamed: RL5_alt1.1, RoutL_5.1, UCC27511ADBV_5.3 (OUTL)
VDC: 2N3904_3.3 (C), 2N3904_8.3 (C), 2N3904_9.3 (C), 2N3904_10.3 (C), 2N3904_11.3 (C), 2N3904_12.3 (C), Q6.2 (C), Q8.2 (C), Q10.2 (C), Q11.2 (C), Q12.2 (C), Q15.2 (C), RH5_alt13.2, RH5_alt15.2, RH5_alt17.2, RH5_alt19.2, RH5_alt21.2, RH5_alt23.2, RH5_alt24.2, RH5_alt26.2, RH5_alt28.2, RH5_alt30.2, RH5_alt32.2, RH5_alt34.2, Rnpn1.2, Rnpn3.2, Rnpn5.2, Rnpn6.2, Rnpn7.2, Rnpn8.2, Rnpn12.2, Rnpn14.2, Rnpn16.2, Rnpn18.2, Rnpn20.2, Rnpn22.2, UCC27511ADBV_1.1 (V_{DD}), UCC27511ADBV_2.1 (V_{DD}), UCC27511ADBV_3.1 (V_{DD}), UCC27511ADBV_4.1 (V_{DD}), UCC27511ADBV_5.1 (V_{DD}), UCC27511ADBV_6.1 (V_{DD})
Vb1: 2N3904_10.2 (B), 2N3904_20.3 (C), BC327_1.2 (B), Q15.1 (B), Q21.1 (B), Q26.2 (C), RH5_alt26.1, Rnpn14.1
Vb2: 2N3904_8.2 (B), 2N3904_22.3 (C), BC327_2.2 (B), Q8.1 (B), Q20.1 (B), Q28.2 (C), RH5_alt30.1, Rnpn18.1
Vb3: 2N3904_3.2 (B), 2N3904_19.3 (C), BC327_3.2 (B), Q6.1 (B), Q19.1 (B), Q25.2 (C), RH5_alt24.1, Rnpn12.1
Vb4: 2N3904_9.2 (B), 2N3904_23.3 (C), BC327_4.2 (B), Q10.1 (B), Q22.1 (B), Q29.2 (C), RH5_alt32.1, Rnpn20.1
Vb5: 2N3904_11.2 (B), 2N3904_21.3 (C), BC327_5.2 (B), Q11.1 (B), Q23.1 (B), Q27.2 (C), RH5_alt28.1, Rnpn16.1
Vb6: 2N3904_12.2 (B), 2N3904_24.3 (C), BC327_6.2 (B), Q12.1 (B), Q24.1 (B), Q30.2 (C), RH5_alt34.1, Rnpn22.1
Vb11: 2N3904_1.3 (C), Q9.2 (C), RH5_alt19.1, RH5_alt27.1, Rnpn1.1, Rnpn15.2
Vb12: 2N3904_20.2 (B), Q26.1 (B), RH5_alt27.2, Rnpn15.1
Vb21: 2N3904_2.3 (C), Q14.2 (C), RH5_alt15.1, RH5_alt31.1, Rnpn7.1, Rnpn19.2
Vb22: 2N3904_22.2 (B), Q28.1 (B), RH5_alt31.2, Rnpn19.1
Vb31: 2N3904_7.3 (C), Q13.2 (C), RH5_alt13.1, RH5_alt25.1, Rnpn3.1, Rnpn13.2
Vb32: 2N3904_19.2 (B), Q25.1 (B), RH5_alt25.2, Rnpn13.1
Vb41: 2N3904_4.3 (C), Q16.2 (C), RH5_alt17.1, RH5_alt33.1, Rnpn8.1, Rnpn21.2
Vb42: 2N3904_23.2 (B), Q29.1 (B), RH5_alt33.2, Rnpn21.1
Vb51: 2N3904_5.3 (C), Q17.2 (C), RH5_alt21.1, RH5_alt29.1, Rnpn5.1, Rnpn17.2
Vb52: 2N3904_21.2 (B), Q27.1 (B), RH5_alt29.2, Rnpn17.1
Vb61: 2N3904_6.3 (C), Q18.2 (C), RH5_alt23.1, RH5_alt35.1, Rnpn6.1, Rnpn23.2
Vb62: 2N3904_24.2 (B), Q30.1 (B), RH5_alt35.2, Rnpn23.1

Notes on the sheet:
Two stage inverters step up 3V3 to VDC to VB3 base
Totem pole driver option (when primary ICs are not available)
TO-223 totem pole option
TO-223 totem pole option (same idea applies to all the others : PTZ222A is a replacement for 2N3904, BCP41 for BC327_1 and Q15 for 2N3904 Replacements are just marked on the board as GD1P for the BCP51, and GD1N, GD1N for Q15 and Q9.
For each of the 6 output MOSFETs: - connect digital signals (GateDriveN) directly to GatedriveN_HI outputs and bypass the gate driver entirely, but only if using logic level MOSFETs - otherwise, for MOSFETs that don't open fully at 3.3V or 5V, for each channel the board allows one of the following 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
UCC27511 gate driver option (primary)
GATE DRIVERS block
TO92 totem pole option
TO-223 totem pole option, if TO92 transistors are not available ! Q13,Q19 and Q6 are marked on the board only as GD3N, GD3N and GD3P, you won't know which is which So if using TO-223s, replace all 2N3904s and BC327s with the TO-223 variants to avoid confusion
TO-223 totem pole option, if TO92 transistors are not available ! Q14,Q20 and Q8 are marked on the board only as GD2N, GD2N and GD2P. They replace all 2N3904s and BC327s in the TO92 pole option
