BrotherLaur/ApocalypseController/Inputs.kicad_sch

## KiCad design Inputs.kicad_sch (2025-10-03)

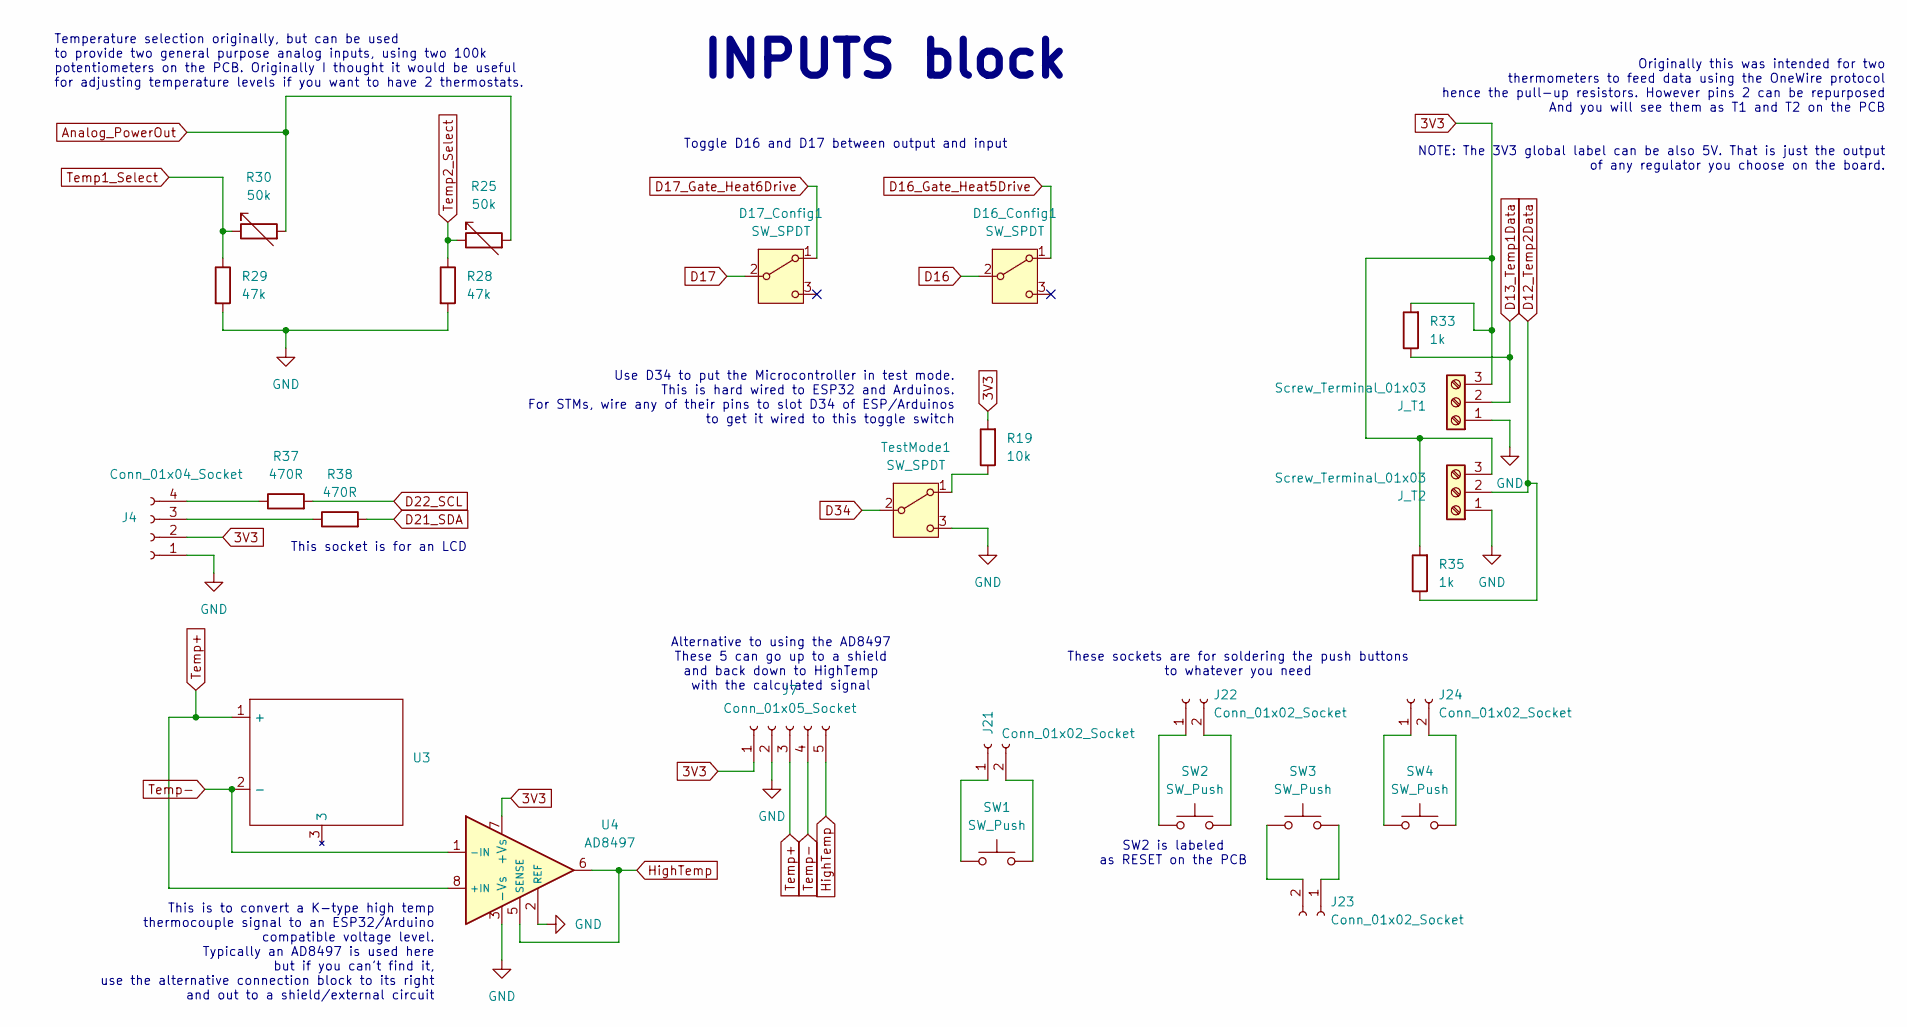
[picture p13: schematic Inputs.kicad_sch]

Parts:
D16_Config1, D17_Config1: SW_SPDT; PinHeader_1x03_P2.54mm_Vertical
J4: Conn_01x04_Socket; PinSocket_1x04_P2.54mm_Vertical
J7: Conn_01x05_Socket; PinSocket_1x05_P2.54mm_Vertical
J21, J22, J23, J24: Conn_01x02_Socket; PinSocket_1x02_P2.54mm_Vertical
J_T1, J_T2: Screw_Terminal_01x03; TerminalBlock_bornier-3_P5.08mm
R19: 10k; R_Axial_Clean
R25, R30: 50k; Potentiometer_Piher_PT-6-V_Vertical_Hole
R28, R29: 47k; R_Axial_Clean
R33, R35: 1k; R_Axial_Clean
R37, R38: 470R; R_Axial_Clean
SW1, SW2, SW3, SW4: SW_Push; SW_PUSH_6mm
TestMode1: SW_SPDT; PinHeader_1x03_P2.54mm_Vertical
U3: k type
U4: AD8497; MSOP-8_3x3mm_P0.65mm

Connections:
3V3: J4.2, J7.1, J_T1.3, J_T2.3, R19.2, R33.2, R35.2, U4.7 (+Vs)
Analog_PowerOut: R25.2, R30.2
D12_Temp2Data: J_T2.2, R35.1
D13_Temp1Data: J_T1.2, R33.1
D16: D16_Config1.2 (B)
D16_Gate_Heat5Drive: D16_Config1.1 (A)
D17: D17_Config1.2 (B)
D17_Gate_Heat6Drive: D17_Config1.1 (A)
D21_SDA: R38.2
D22_SCL: R37.2
D34: TestMode1.2 (B)
GND: J4.1, J7.2, J_T1.1, J_T2.1, R28.2, R29.2, TestMode1.3 (C), U4.2 (REF), U4.3 (-Vs)
HighTemp: J7.5, U4.5 (SENSE), U4.6
unnamed: J4.3, R38.1
unnamed: J4.4, R37.1
unnamed: J21.1, SW1.1
unnamed: J21.2, SW1.2
unnamed: J22.1, SW2.1
unnamed: J22.2, SW2.2
unnamed: J23.1, SW3.2
unnamed: J23.2, SW3.1
unnamed: J24.1, SW4.1
unnamed: J24.2, SW4.2
unnamed: R19.1, TestMode1.1 (A)
Temp1_Select: R29.1, R30.1
Temp2_Select: R25.1, R28.1
Temp+: J7.3, U3.1 (+), U4.8 (+IN)
Temp-: J7.4, U3.2 (-), U4.1 (-IN)

Notes on the sheet:
INPUTS block
Originally this was intended for two thermometers to feed data using the OneWire protocol hence the pull-up resistors. However pins 2 can be repurposed And you will see them as T1 and T2 on the PCB NOTE: The 3V3 global label can be also 5V. That is just the output of any regulator you choose on the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
Use D34 to put the Microcontroller in test mode. This is hard wired to ESP32 and Arduinos. For STMs, wire any of their pins to slot D34 of ESP/Arduinos to get it wired to this toggle switch
These sockets are for soldering the push buttons to whatever you need
Alternative to using the AD8497 These 5 can go up to a shield and back down to HighTemp with the calculated signal
Temperature selection originally, but can be used to provide two general purpose analog inputs, using two 100k potentiometers on the PCB. Originally I thought it would be useful for adjusting temperature levels if you want to have 2 thermostats.
SW2 is labeled as RESET on the PCB
This socket is for an LCD
This is to convert a K-type high temp thermocouple signal to an ESP32/Arduino compatible voltage level. Typically an AD8497 is used here but if you can't find it, use the alternative connection block to its right and out to a shield/external circuit
Toggle D16 and D17 between output and input
