BrotherLaur/ApocalypseController/OutputMosfets.kicad_sch

## KiCad design OutputMosfets.kicad_sch (2025-10-03)

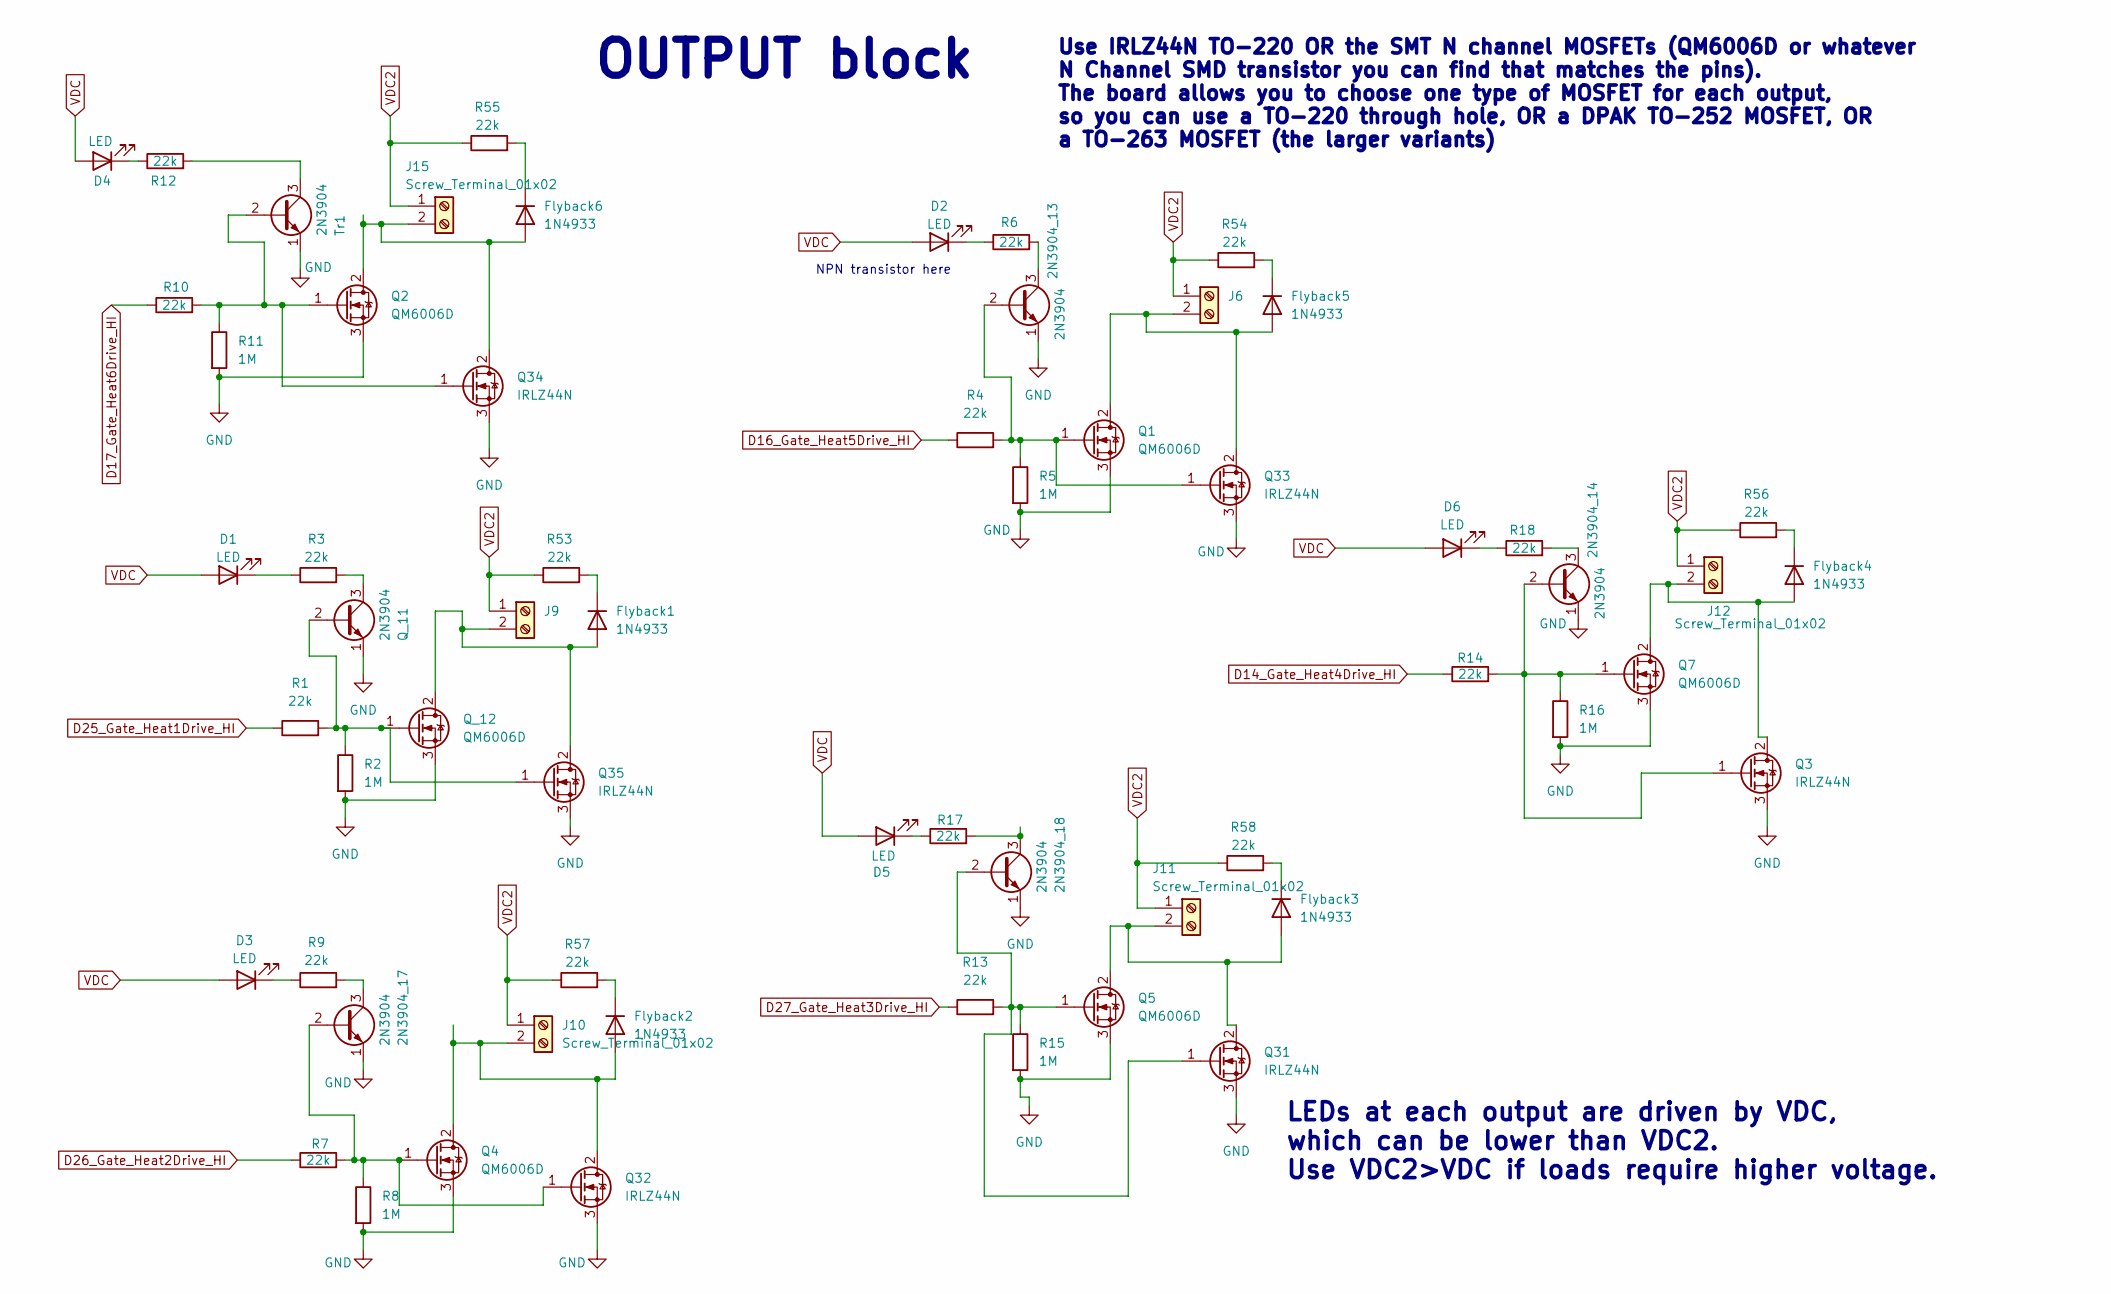
[picture p14: schematic OutputMosfets.kicad_sch]

Parts:
2N3904_13, 2N3904_14, 2N3904_17, 2N3904_18: 2N3904; TO-92_Expanded
D1, D2, D3, D4, D5, D6: LED; LED_1206_3216Metric_Pad1.42x1.75mm_HandSolder
Flyback1, Flyback2, Flyback3, Flyback4, Flyback5, Flyback6: 1N4933; D_DO-41_SOD81_P10.16mm_Horizontal
J6, J9, J10, J11, J12: Screw_Terminal_01x02; TerminalBlock_CLEAN_2PIN
J15: Screw_Terminal_01x02; TerminalBlock_bornier-2_P5.08mm
Q1, Q2, Q4, Q5, Q7: QM6006D; TO-263-2_Extended
Q3, Q31, Q32, Q33, Q34, Q35: IRLZ44N; TO-220-3_EXTENDED
Q_11: 2N3904; TO-92_Expanded
Q_12: QM6006D; TO-263-2_Extended
R1, R3, R4, R6, R7, R9, R10, R12, R13, R14, R17, R18, R53, R54, R55, R56, R57, R58: 22k; R_Axial_Clean
R2, R5, R8, R11, R15, R16: 1M; R_Axial_Clean
Tr1: 2N3904; TO-92_Expanded

Connections:
D14_Gate_Heat4Drive_HI: R14.1
D16_Gate_Heat5Drive_HI: R4.1
D17_Gate_Heat6Drive_HI: R10.1
D25_Gate_Heat1Drive_HI: R1.1
D26_Gate_Heat2Drive_HI: R7.1
D27_Gate_Heat3Drive_HI: R13.1
GND: 2N3904_13.1 (E), 2N3904_14.1 (E), 2N3904_17.1 (E), 2N3904_18.1 (E), Q1.3 (S), Q2.3 (S), Q3.3 (S), Q4.3 (S), Q5.3 (S), Q7.3 (S), Q31.3 (S), Q32.3 (S), Q33.3 (S), Q34.3 (S), Q35.3 (S), Q_11.1 (E), Q_12.3 (S), R2.2, R5.2, R8.2, R11.2, R15.2, R16.2, Tr1.1 (E)
unnamed: 2N3904_13.2 (B), Q1.1 (G), Q33.1 (G), R4.2, R5.1
unnamed: 2N3904_13.3 (C), R6.2
unnamed: 2N3904_14.2 (B), Q3.1 (G), Q7.1 (G), R14.2, R16.1
unnamed: 2N3904_14.3 (C), R18.2
unnamed: 2N3904_17.2 (B), Q4.1 (G), Q32.1 (G), R7.2, R8.1
unnamed: 2N3904_17.3 (C), R9.2
unnamed: 2N3904_18.2 (B), Q5.1 (G), Q31.1 (G), R13.2, R15.1
unnamed: 2N3904_18.3 (C), R17.2
unnamed: D1.1 (K), R3.1
unnamed: D2.1 (K), R6.1
unnamed: D3.1 (K), R9.1
unnamed: D4.1 (K), R12.1
unnamed: D5.1 (K), R17.1
unnamed: D6.1 (K), R18.1
unnamed: Flyback1.1 (K), R53.2
unnamed: Flyback1.2 (A), J9.2, Q35.2 (D), Q_12.2 (D)
unnamed: Flyback2.1 (K), R57.2
unnamed: Flyback2.2 (A), J10.2, Q4.2 (D), Q32.2 (D)
unnamed: Flyback3.1 (K), R58.2
unnamed: Flyback3.2 (A), J11.2, Q5.2 (D), Q31.2 (D)
unnamed: Flyback4.1 (K), R56.2
unnamed: Flyback4.2 (A), J12.2, Q3.2 (D), Q7.2 (D)
unnamed: Flyback5.1 (K), R54.2
unnamed: Flyback5.2 (A), J6.2, Q1.2 (D), Q33.2 (D)
unnamed: Flyback6.1 (K), R55.2
unnamed: Flyback6.2 (A), J15.2, Q2.2 (D), Q34.2 (D)
unnamed: Q2.1 (G), Q34.1 (G), R10.2, R11.1, Tr1.2 (B)
unnamed: Q35.1 (G), Q_11.2 (B), Q_12.1 (G), R1.2, R2.1
unnamed: Q_11.3 (C), R3.2
unnamed: R12.2, Tr1.3 (C)
VDC: D1.2 (A), D2.2 (A), D3.2 (A), D4.2 (A), D5.2 (A), D6.2 (A)
VDC2: J6.1, J9.1, J10.1, J11.1, J12.1, J15.1, R53.1, R54.1, R55.1, R56.1, R57.1, R58.1

Notes on the sheet:
OUTPUT block
NPN transistor here
Use IRLZ44N TO-220 OR the SMT N channel MOSFETs (QM6006D or whatever N Channel SMD transistor you can find that matches the pins). The board allows you to choose one type of MOSFET for each output, so you can use a TO-220 through hole, OR a DPAK TO-252 MOSFET, OR a TO-263 MOSFET (the larger variant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
LEDs at each output are driven by VDC, which can be lower than VDC2. Use VDC2>VDC if loads require higher voltage.
