BrotherLaur/ApocalypseController/Power.kicad_sch

## KiCad design Power.kicad_sch (2025-10-03)

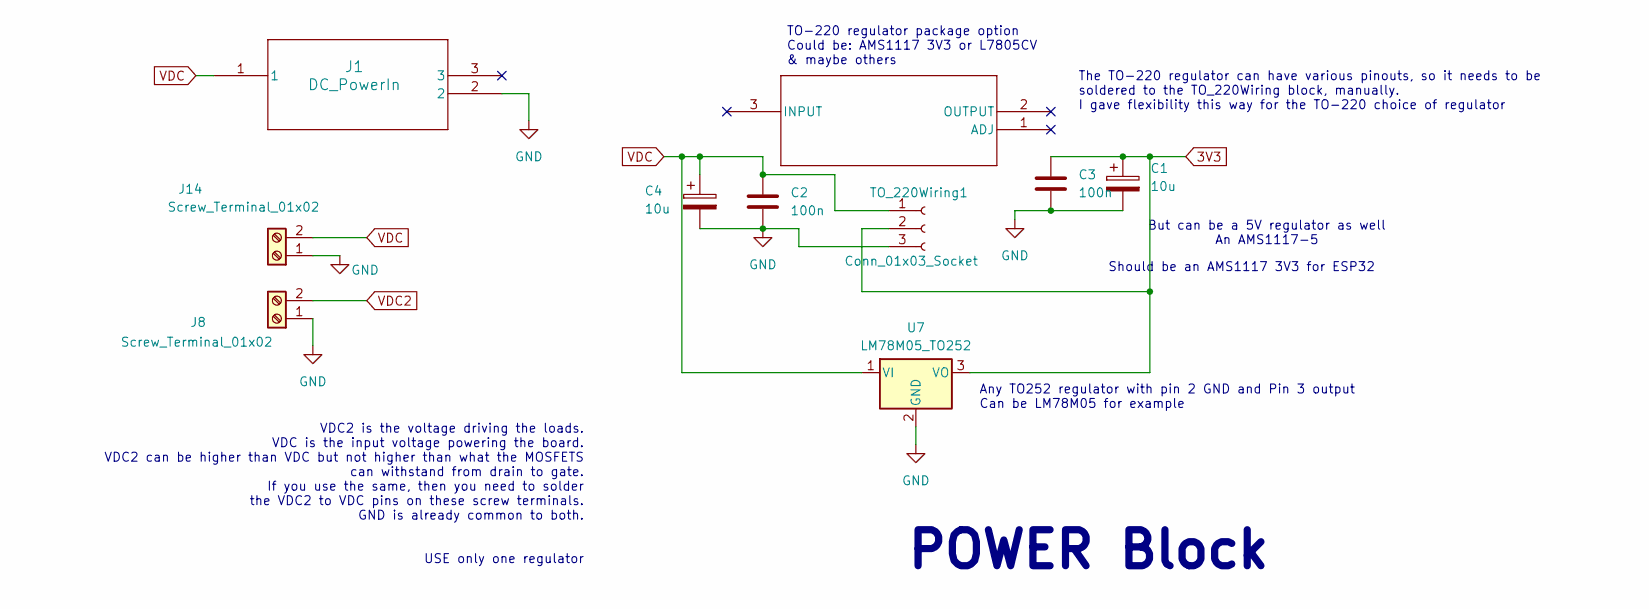
[picture p15: schematic Power.kicad_sch]

Parts:
AMS11173V3: LM317T; TO-220-3_Horizontal_TabDown
C1, C4: 10u; CP_Elec_6.3x3.9
C2, C3: 100n; C_Rect_L7.0mm_W3.5mm_P5.00mm
J1: DC_PowerIn; BarrelJack_Horizontal
J8: Screw_Terminal_01x02; TerminalBlock_CLEAN_2PIN
J14: Screw_Terminal_01x02; TerminalBlock_bornier-2_P5.08mm
TO_220Wiring1: Conn_01x03_Socket; PinHeader_1x03_P2.54mm_Vertical
U7: LM78M05_TO252; TO-252-2

Connections:
3V3: C1.1, C3.1, TO_220Wiring1.2, U7.3 (VO)
GND: C1.2, C2.2, C3.2, C4.2, J1.2, J8.1, J14.1, TO_220Wiring1.3, U7.2 (GND)
VDC: C2.1, C4.1, J1.1, J14.2, TO_220Wiring1.1, U7.1 (VI)
VDC2: J8.2

Notes on the sheet:
Should be an AMS1117 3V3 for ESP32
The TO-220 regulator can have various pinouts, so it needs to be soldered to the TO_220Wiring block, manually. I gave flexibility this way for the TO-220 choice of regulator
POWER Block
But can be a 5V regulator as well An AMS1117-5
TO-220 regulator package option Could be: AMS1117 3V3 or L7805CV & maybe others
Any TO252 regulator with pin 2 GND and Pin 3 output Can be LM78M05 for example
VDC2 is the voltage driving the loads. VDC is the input voltage powering the board. VDC2 can be higher than VDC but not higher than what the MOSFETS can withstand from drain to gate. If you use the same, then you need to solder the VDC2 to VDC pins on these screw terminals. GND is already common to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
