BrotherLaur/ApocalypseController/(commit log)

2025-09-14 Initial commit for release 1
    [ControlChips.kicad_sch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]
2025-09-14 Release 1.0
    [ControlChips.kicad_sch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]
2025-09-27 Release 1.1
    [ControlChips.kicad_sch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]
2025-10-03 Release 1.2
    [ControlChips.kicad_sch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]
